jakedrew/SmartWatch/Version/D1/Board/PCB Cropped Final-1.jpg

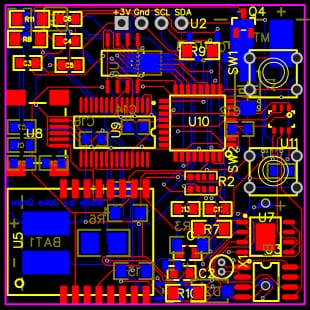
Version/D1/Board/PCB Cropped Final-1.jpg
