jakedrew/SmartWatch/Version/D2/Board/SmartWatch D2 PCB/PCB_SmartWatch D2 PCB_2020-10-05_16-55-16.png

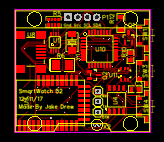
Version/D2/Board/SmartWatch D2 PCB/PCB_SmartWatch D2 PCB_2020-10-05_16-55-16.png
