jakedrew/SmartWatch/Version/D1/Board/V1/PCB_V1_2020-10-05_14-33-06.pdf

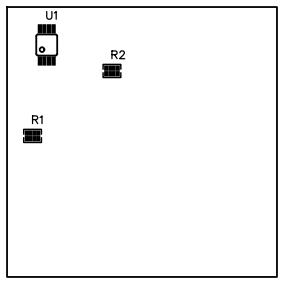
[picture p40: figure]
