jakedrew/SmartWatch/Version/D1/Board/V1/PCB_V1_2020-10-05_14-34-22.pdf

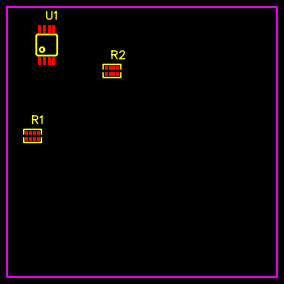
[picture p41: figure]
