jakedrew/SmartWatch/Datasheets/ATMega328/Screen Shot 2017-11-06 at 10.45.25.png

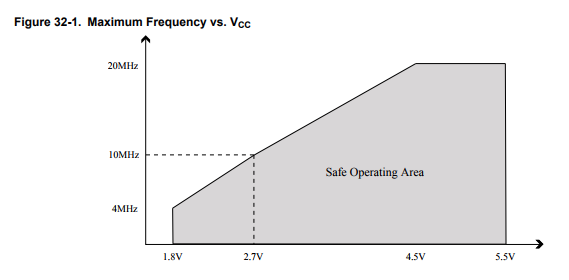
Datasheets/ATMega328/Screen Shot 2017-11-06 at 10.45.25.png
