jakedrew/SmartWatch/Datasheets/ATMega328/Screen Shot 2017-11-15 at 13.26.10.png

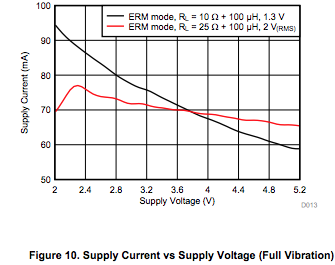
Datasheets/ATMega328/Screen Shot 2017-11-15 at 13.26.10.png
