jakedrew/SmartWatch/Datasheets/ATMega328/Screen Shot 2017-11-15 at 13.30.06.png

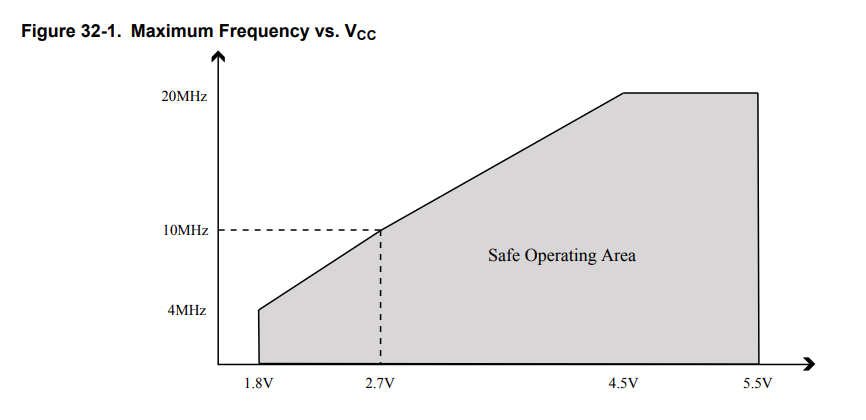
Datasheets/ATMega328/Screen Shot 2017-11-15 at 13.30.06.png
