jakedrew/SmartWatch/Datasheets/ATMega328/Screen Shot 2017-11-21 at 15.36.22.png

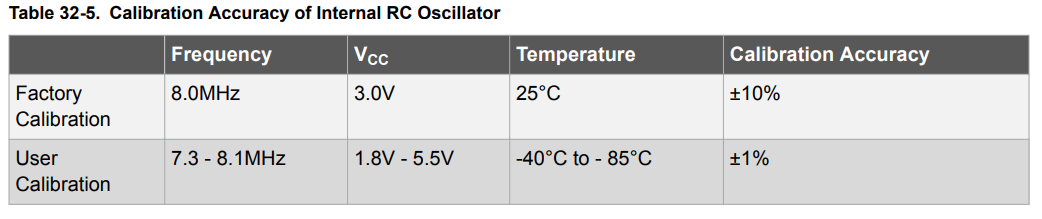
Datasheets/ATMega328/Screen Shot 2017-11-21 at 15.36.22.png
