jakedrew/SmartWatch/Datasheets/ATMega328/Screen Shot 2017-11-21 at 15.51.56.png

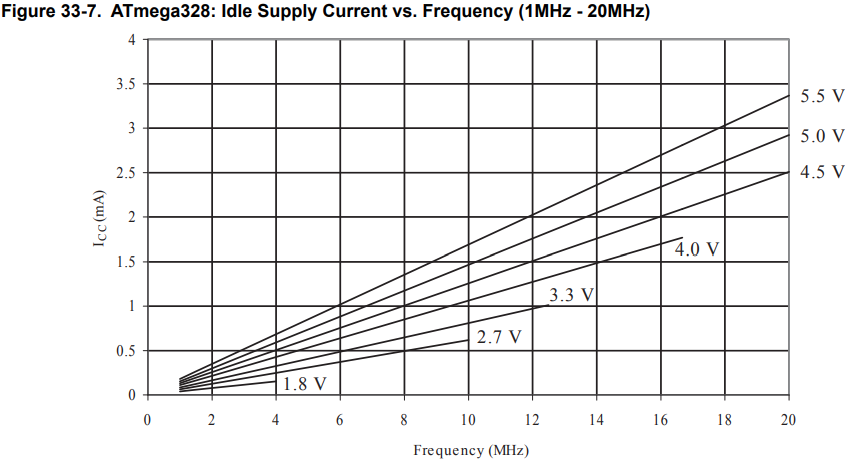
Datasheets/ATMega328/Screen Shot 2017-11-21 at 15.51.56.png
