jakedrew/SmartWatch/Datasheets/DRV2605L/Screen Shot 2017-11-17 at 13.19.39.png

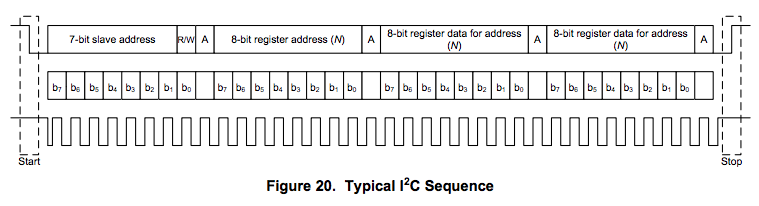
Datasheets/DRV2605L/Screen Shot 2017-11-17 at 13.19.39.png
