jakedrew/SmartWatch/Datasheets/DRV2605L/Screen Shot 2017-11-17 at 13.20.35.png

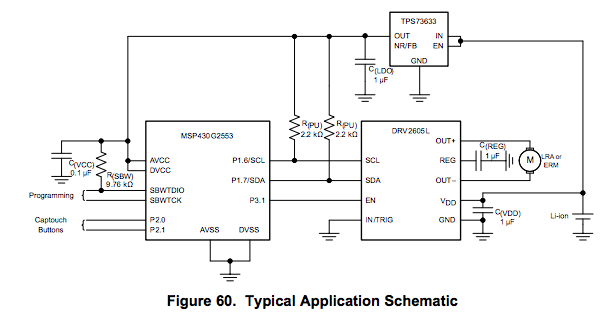
Datasheets/DRV2605L/Screen Shot 2017-11-17 at 13.20.35.png
