jakedrew/SmartWatch/Datasheets/DS1338Z-33/Screen Shot 2017-11-17 at 13.15.22.png

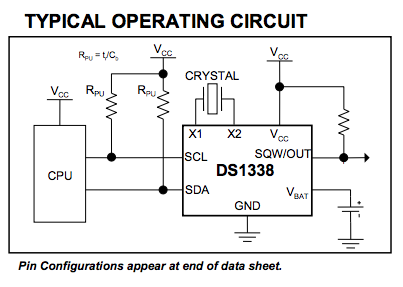
Datasheets/DS1338Z-33/Screen Shot 2017-11-17 at 13.15.22.png
