jakedrew/SmartWatch/Datasheets/MCP9808-EMS/Screen Shot 2017-11-17 at 13.23.54.png

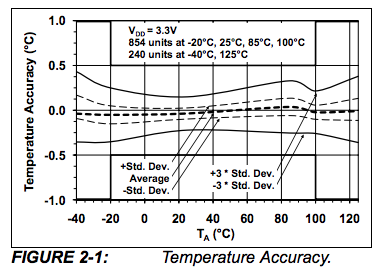
Datasheets/MCP9808-EMS/Screen Shot 2017-11-17 at 13.23.54.png
