jakedrew/SmartWatch/Datasheets/MCP9808-EMS/Screen Shot 2017-11-17 at 13.25.48.png

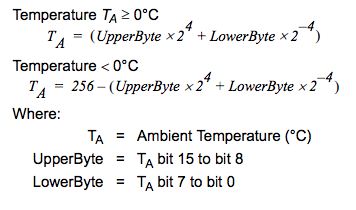
Datasheets/MCP9808-EMS/Screen Shot 2017-11-17 at 13.25.48.png
