jakedrew/SmartWatch/Datasheets/REG710NA-3.33K/Screen Shot 2017-11-17 at 13.33.44.png

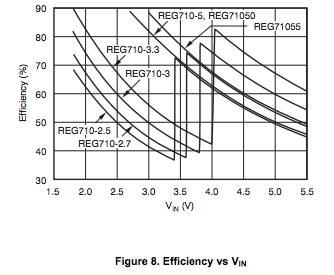
Datasheets/REG710NA-3.33K/Screen Shot 2017-11-17 at 13.33.44.png
