jakedrew/SmartWatch/output_14_0.png

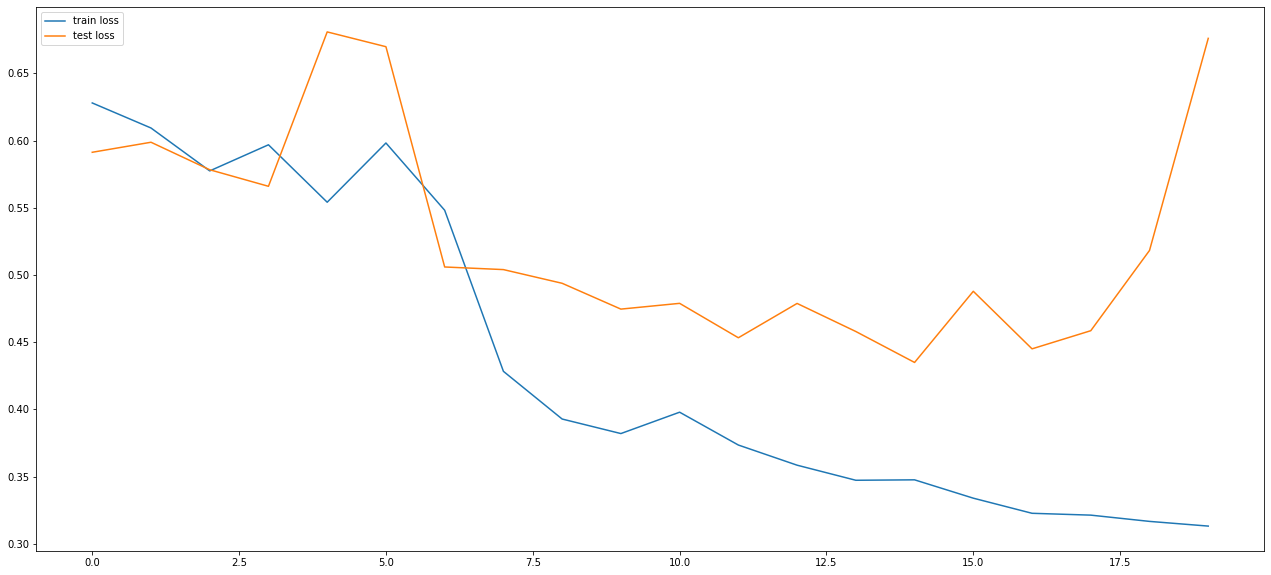
output_14_0.png
