jakedrew/SmartWatch/output_15_0.png

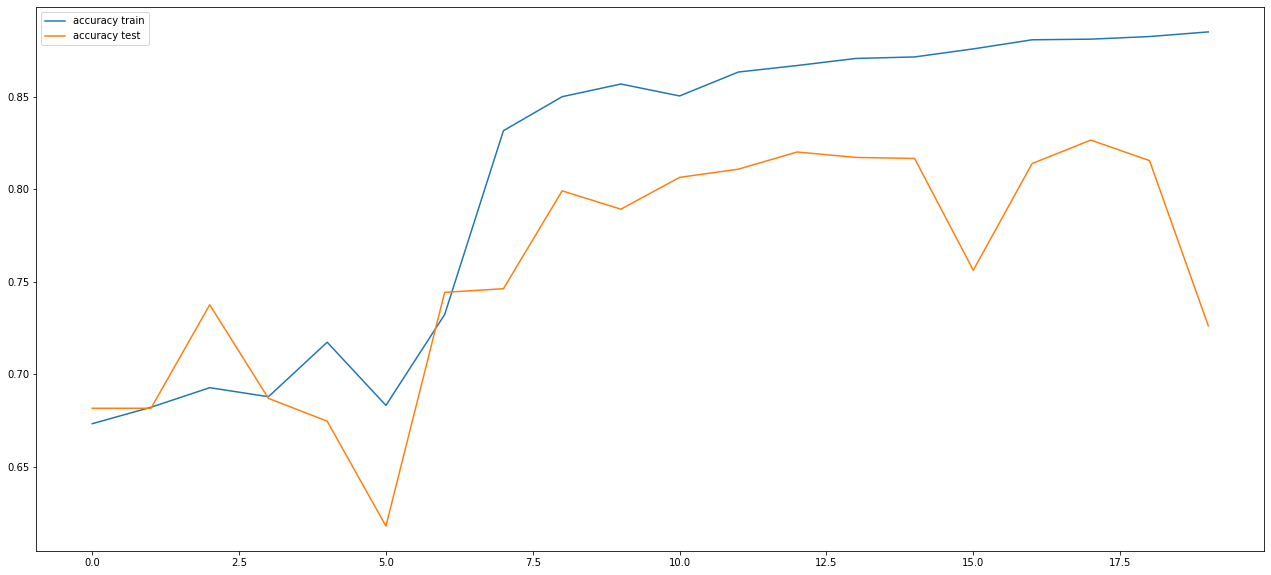
output_15_0.png
