jakedrew/SmartWatch/output_23_0.png

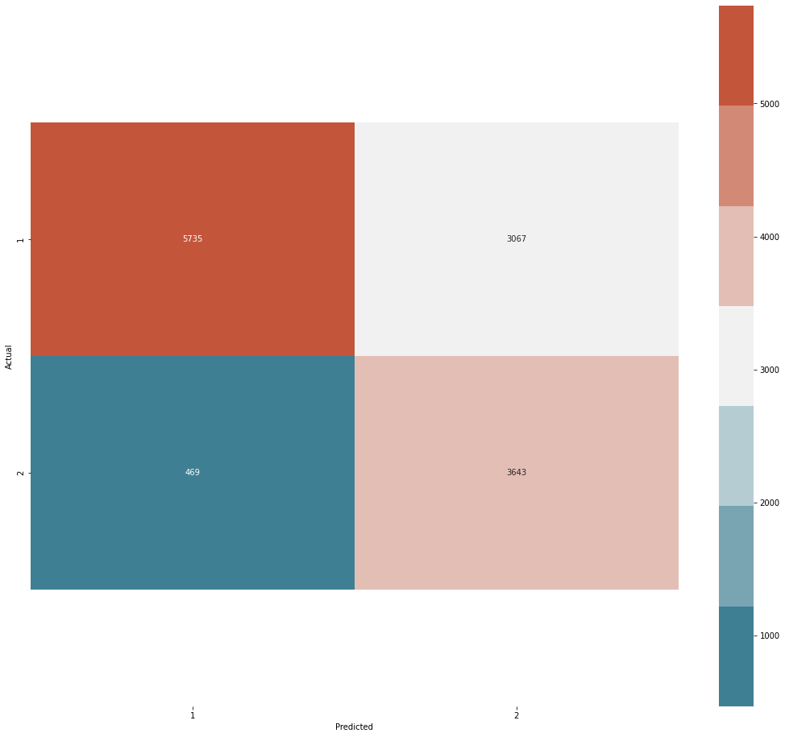
output_23_0.png
