jakedrew/SmartWatch/output_24_0.png

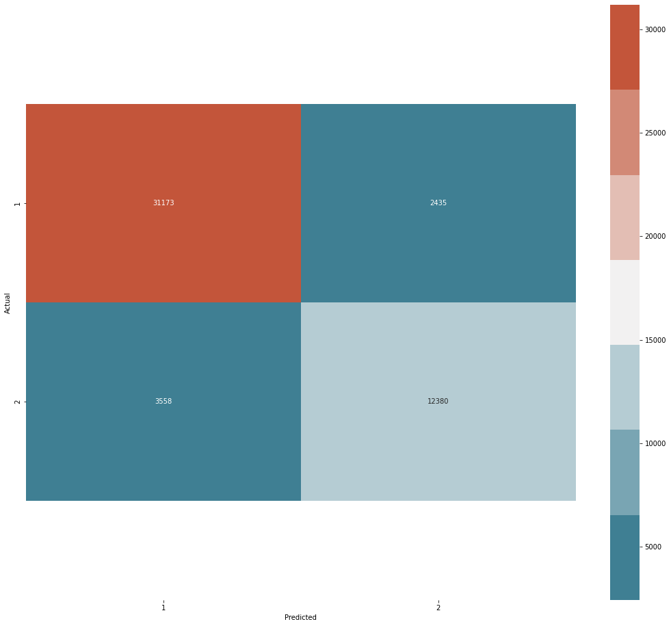
output_24_0.png
