jakedrew/SmartWatch/output_25_0.png

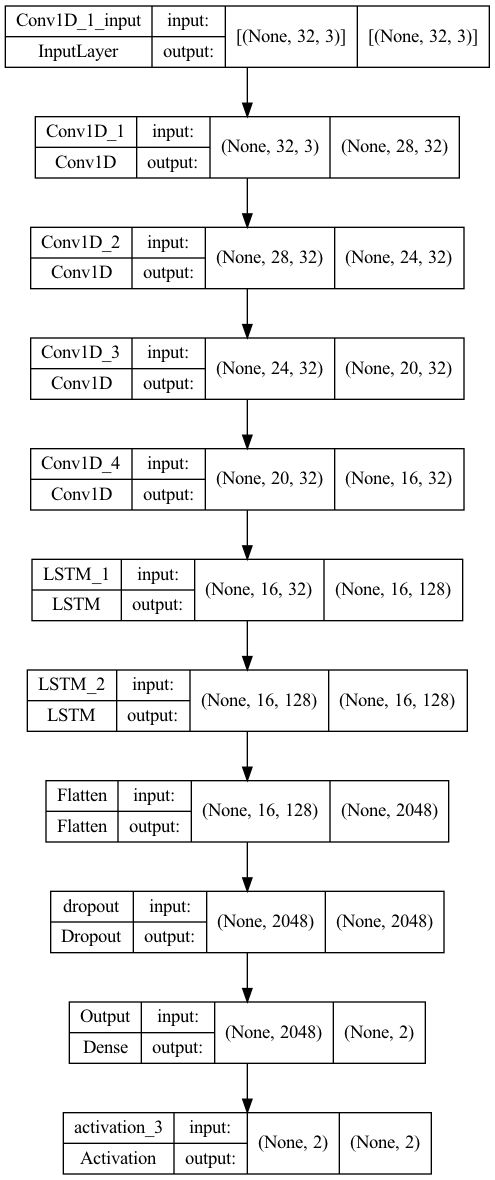
output_25_0.png
