jakedrew/SmartWatch/Version/D1/Board/Fin/PCB_Fin_2020-10-05_16-10-18.png

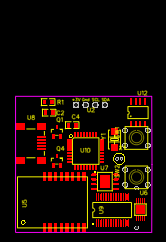
Version/D1/Board/Fin/PCB_Fin_2020-10-05_16-10-18.png
