jakedrew/SmartWatch/Version/D1/Board/New PCB/PCB_New PCB_2020-10-05_14-35-52.png

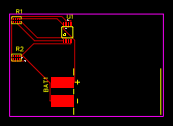
Version/D1/Board/New PCB/PCB_New PCB_2020-10-05_14-35-52.png
