jakedrew/SmartWatch/Version/D1/Board/PCB1/PCB_PCB1_2020-10-05_14-45-28.png

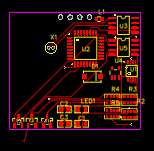
Version/D1/Board/PCB1/PCB_PCB1_2020-10-05_14-45-28.png
