jakedrew/SmartWatch/Version/D1/Circuit/V1.1/Schematic_D1_2020-10-05_14-30-19.png

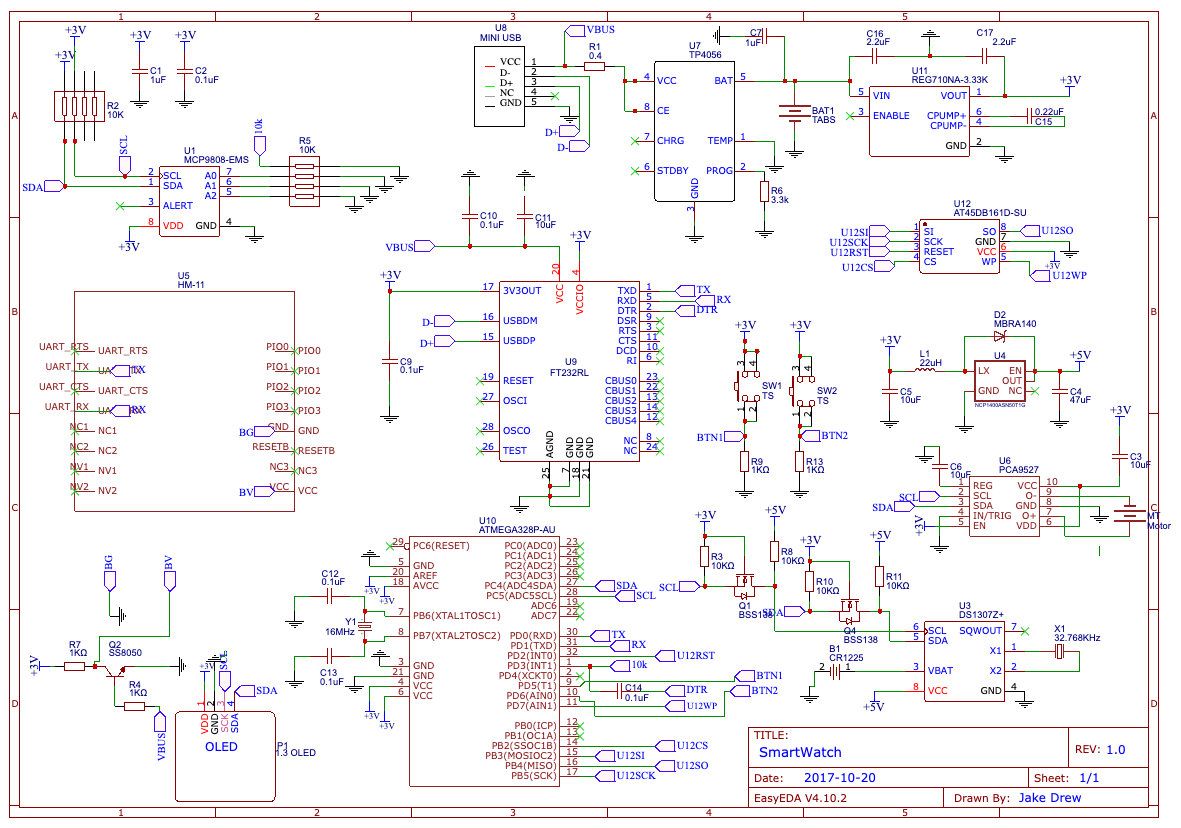
Version/D1/Circuit/V1.1/Schematic_D1_2020-10-05_14-30-19.png
