jakedrew/SmartWatch/Version/D2/Board/New PCB/PCB_New PCB_2020-10-05_16-17-32.png

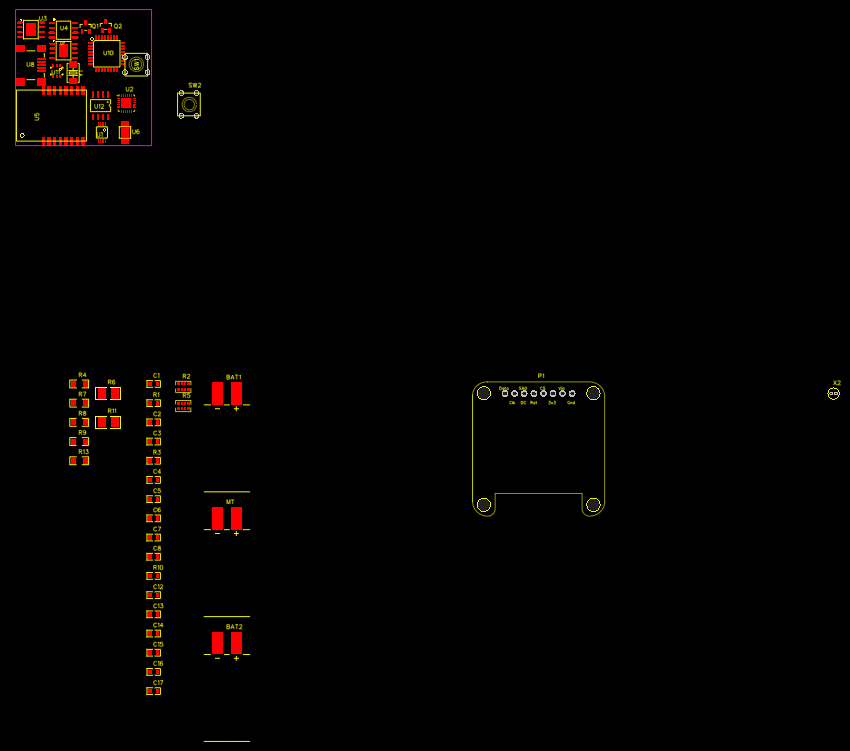
Version/D2/Board/New PCB/PCB_New PCB_2020-10-05_16-17-32.png
