jakedrew/SmartWatch/Version/D3/Circuit/V4.1/V4.1.png

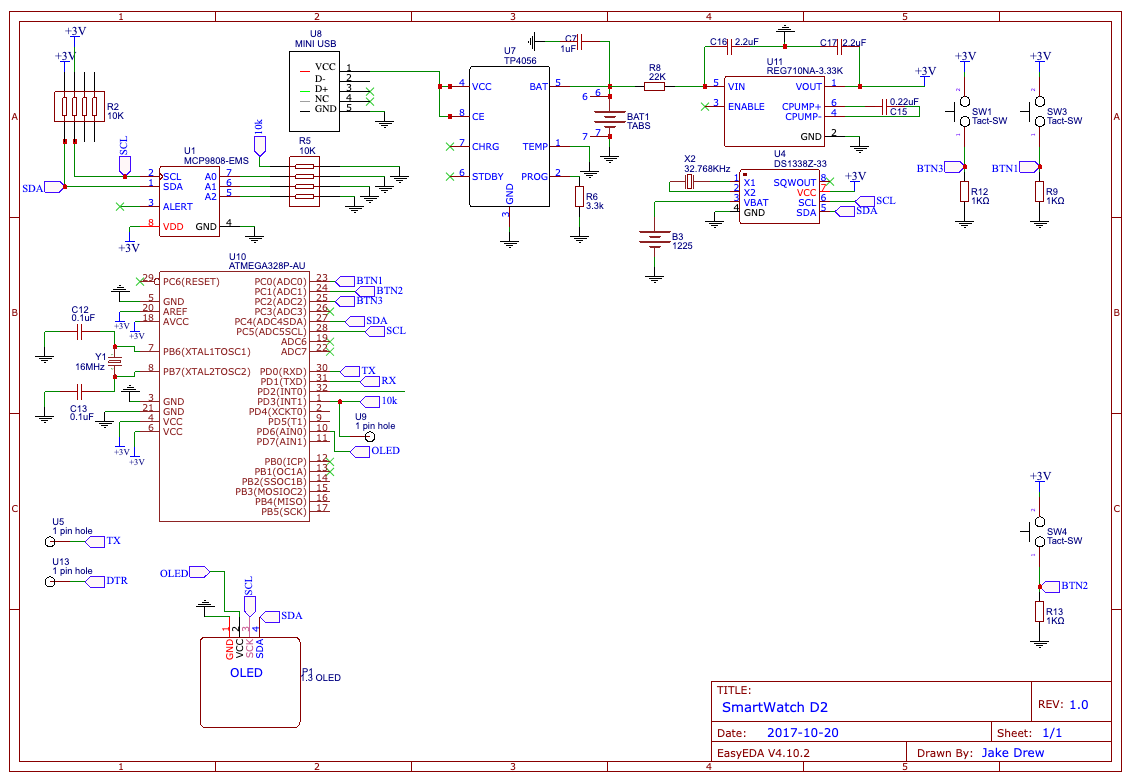
Version/D3/Circuit/V4.1/V4.1.png
