jakedrew/SmartWatch/Version/D4/Board/PCB_D4_2020-10-05_17-05-44.png

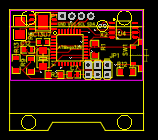
Version/D4/Board/PCB_D4_2020-10-05_17-05-44.png
