jakedrew/SmartWatch/Version/D4/Circuit/V4.1/Schematic_D4_2020-10-05_17-04-26.png

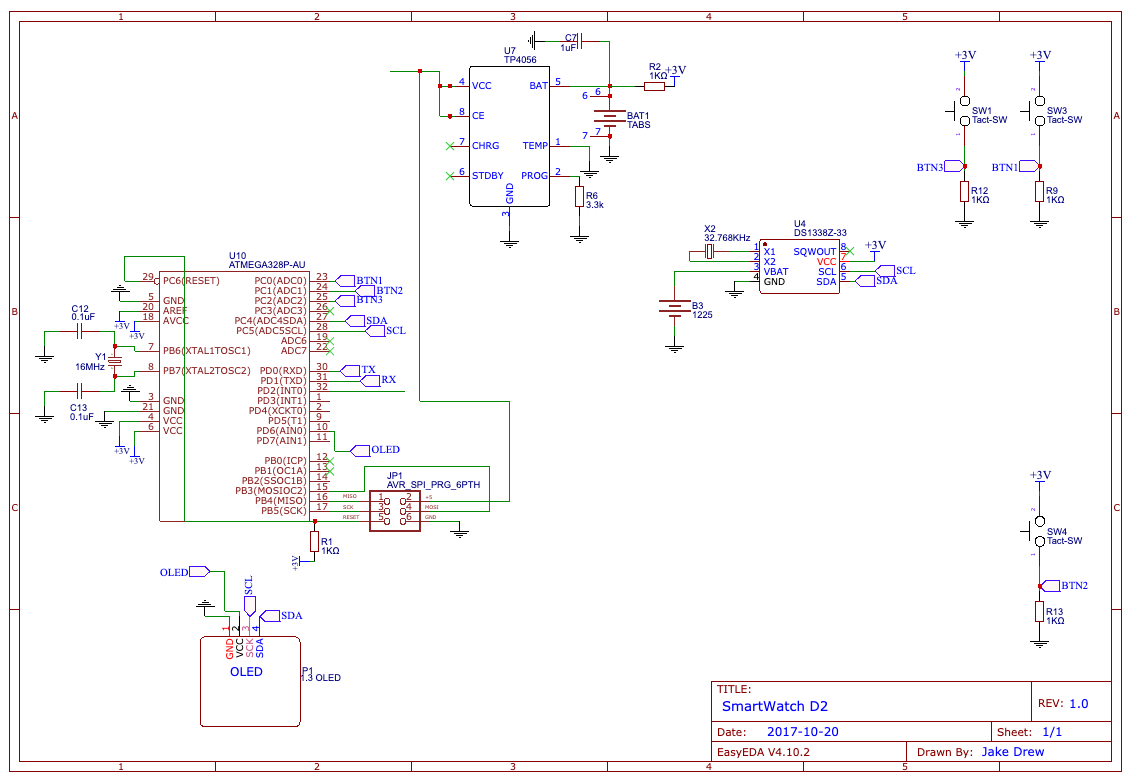
Version/D4/Circuit/V4.1/Schematic_D4_2020-10-05_17-04-26.png
