jakedrew/SmartWatch/Version/D5/Board/Images/BoardOutLine.png

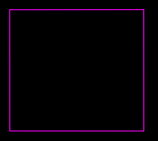
Version/D5/Board/Images/BoardOutLine.png
