jakedrew/SmartWatch/Version/D5/Board/Images/BottomLayer.png

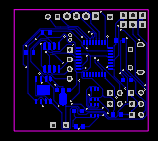
Version/D5/Board/Images/BottomLayer.png
