jakedrew/SmartWatch/Version/D5/Board/Images/BottomPasteMaskLayer.png

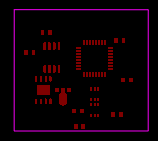
Version/D5/Board/Images/BottomPasteMaskLayer.png
