jakedrew/SmartWatch/Version/D5/Board/Images/BottomSilkLayer.png

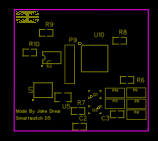
Version/D5/Board/Images/BottomSilkLayer.png
