jakedrew/SmartWatch/Version/D5/Board/Images/Multi-Layer.png

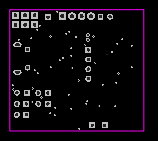
Version/D5/Board/Images/Multi-Layer.png
