jakedrew/SmartWatch/Version/D5/Board/Images/TopLayer.png

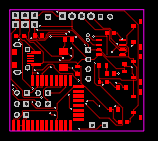
Version/D5/Board/Images/TopLayer.png
