jakedrew/SmartWatch/Version/D5/Board/Images/TopPasteMaskLayer.png

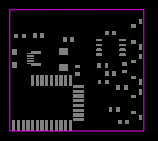
Version/D5/Board/Images/TopPasteMaskLayer.png
