jakedrew/SmartWatch/Version/D5/Board/Images/TopSilkLayer.png

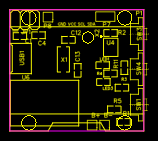
Version/D5/Board/Images/TopSilkLayer.png
