jakedrew/SmartWatch/Version/D5/Circuit/ADT75/ADT75.png

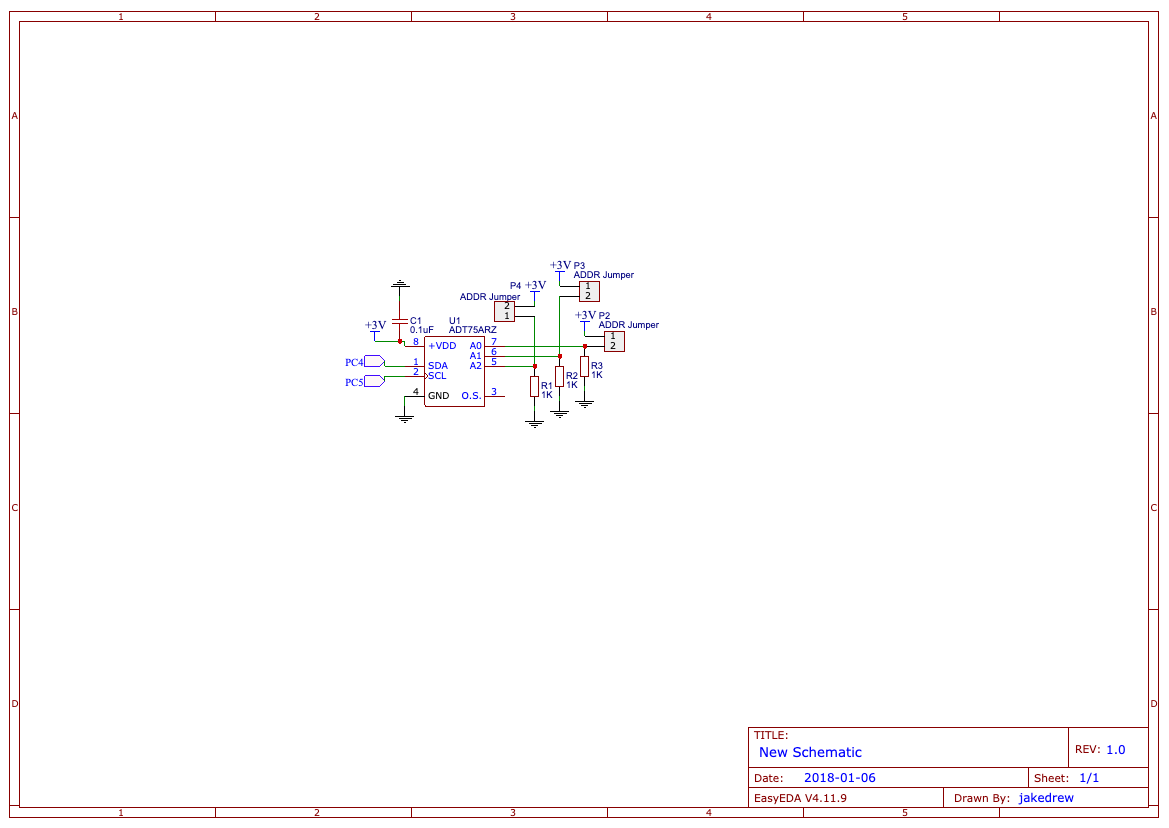
Version/D5/Circuit/ADT75/ADT75.png
