jakedrew/SmartWatch/Version/D5/Circuit/BMP180/BMP180.png

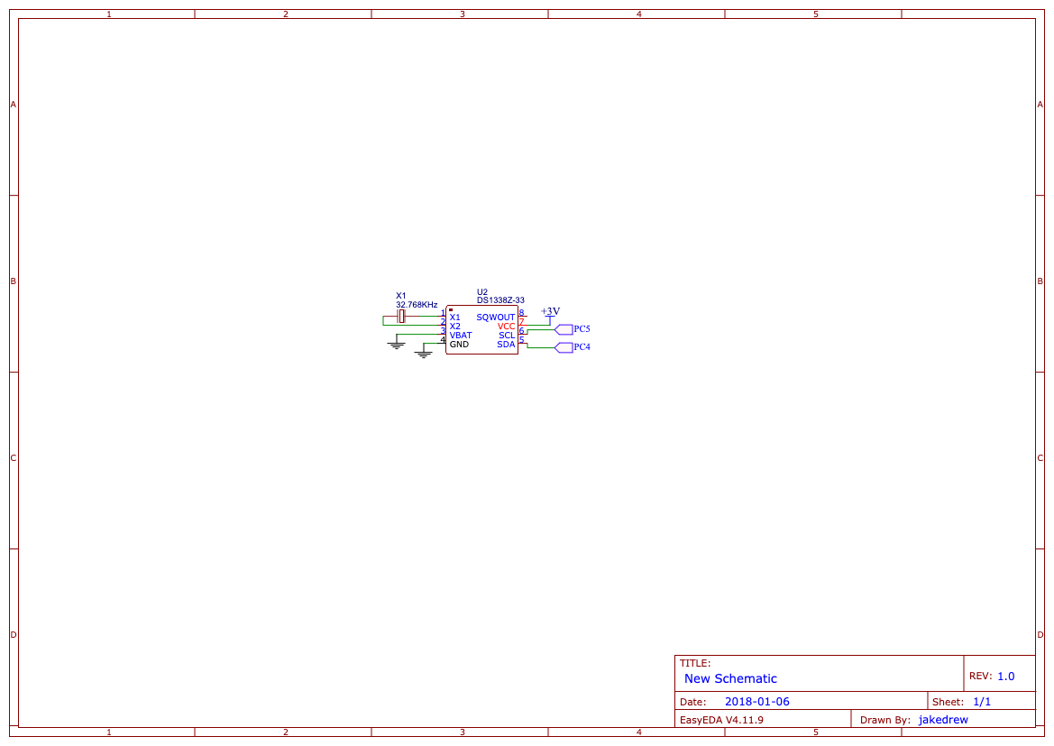
Version/D5/Circuit/BMP180/BMP180.png
