jakedrew/SmartWatch/Version/D5/Circuit/DS1338/DS1338.png

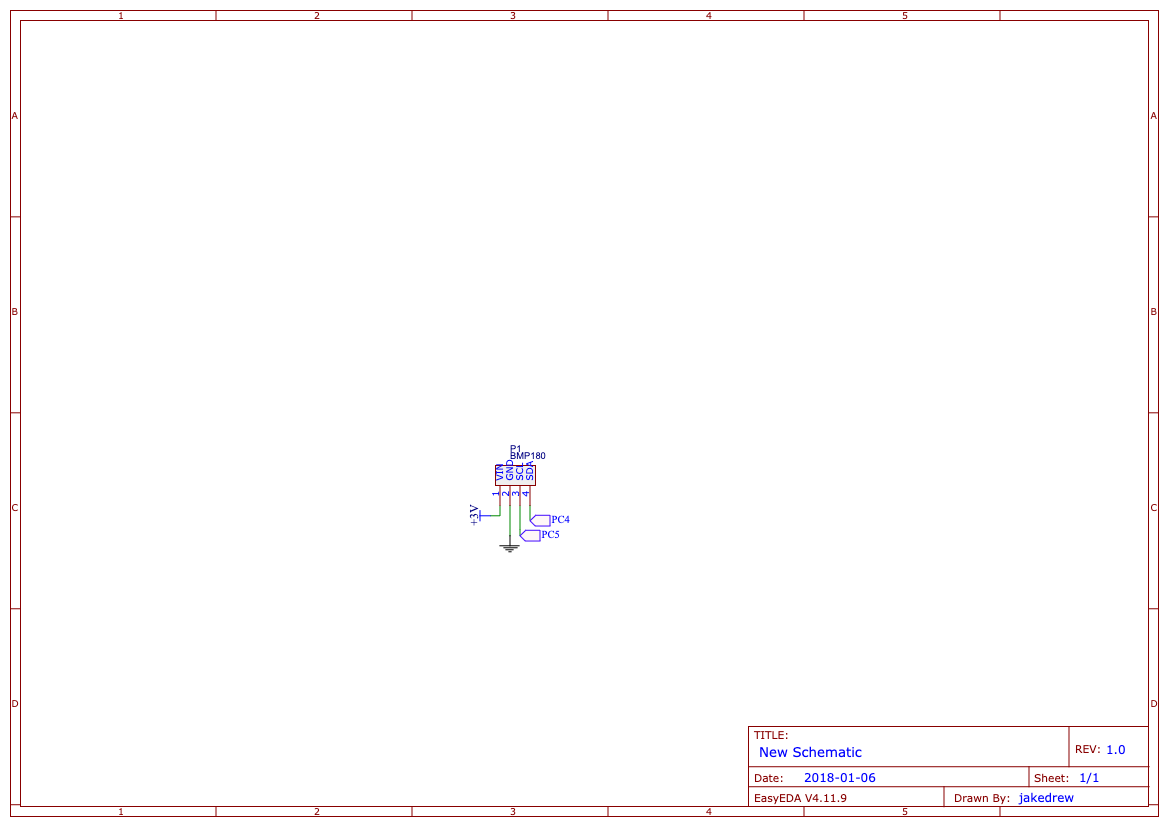
Version/D5/Circuit/DS1338/DS1338.png
