jakedrew/SmartWatch/Version/D5/Circuit/OLED/OLED.png

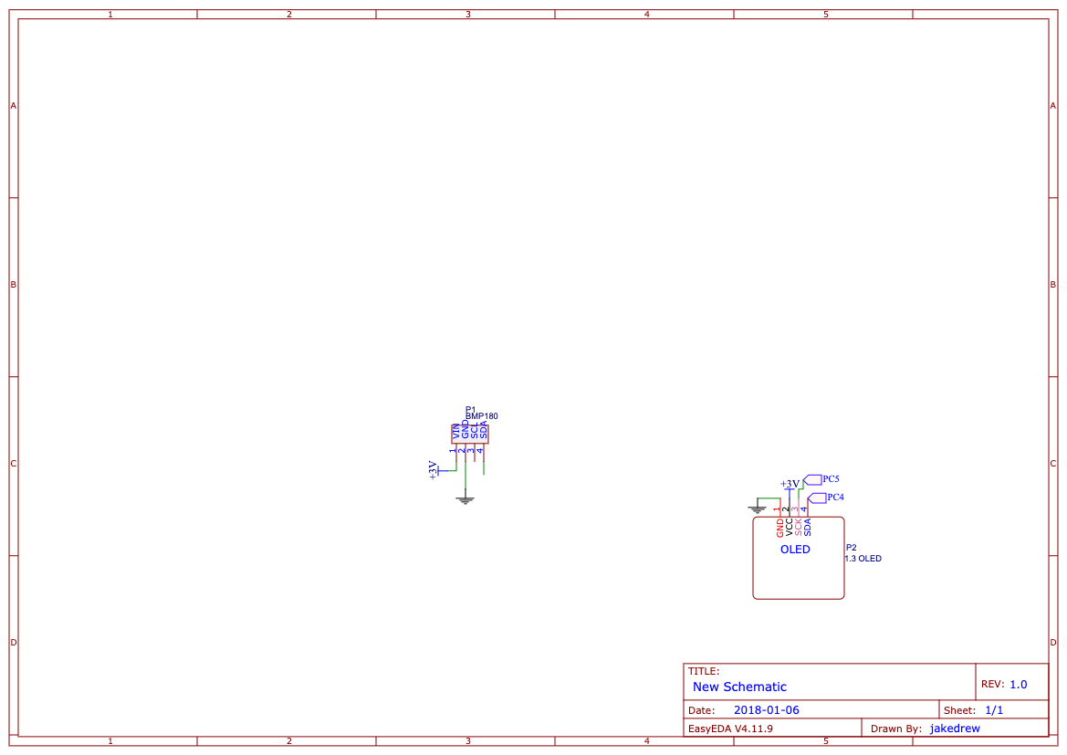
Version/D5/Circuit/OLED/OLED.png
