jakedrew/SmartWatch/Version/D5/Circuit/Power management/Power management.png

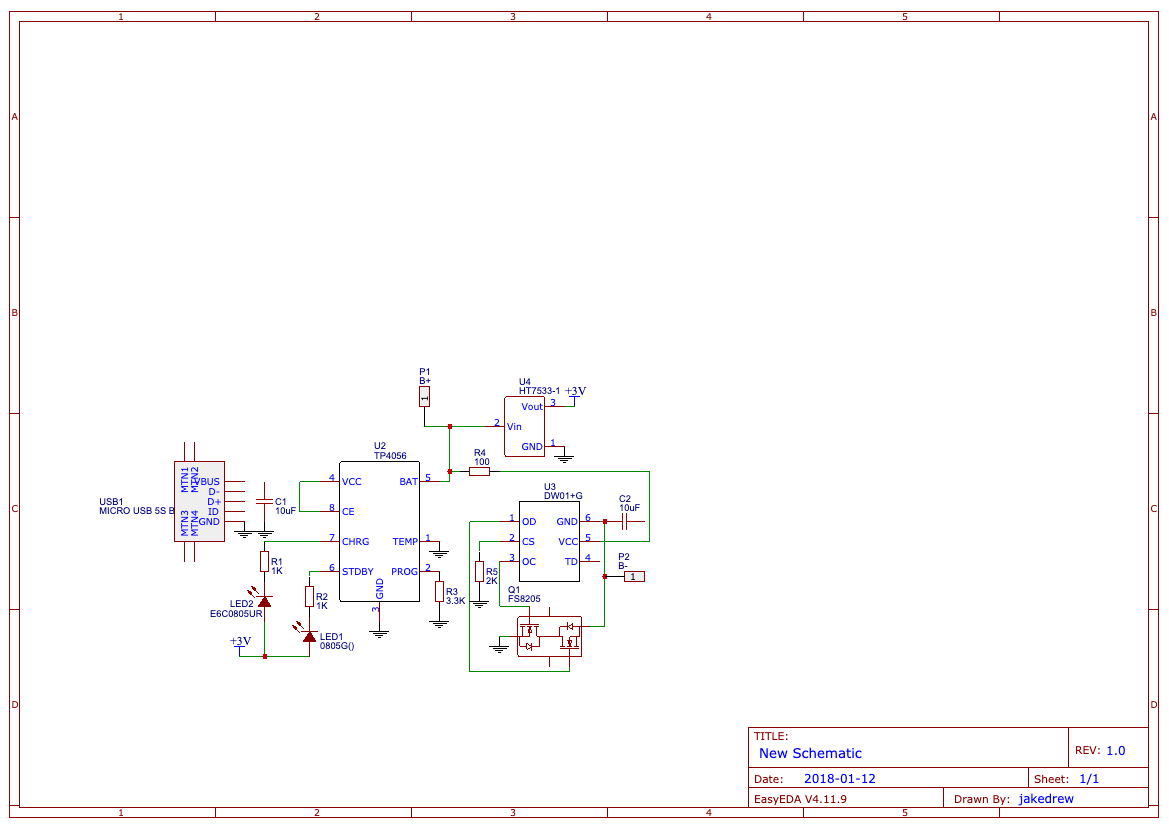
Version/D5/Circuit/Power management/Power management.png
