jakedrew/SmartWatch/Version/D5/Circuit/V5/V5.png

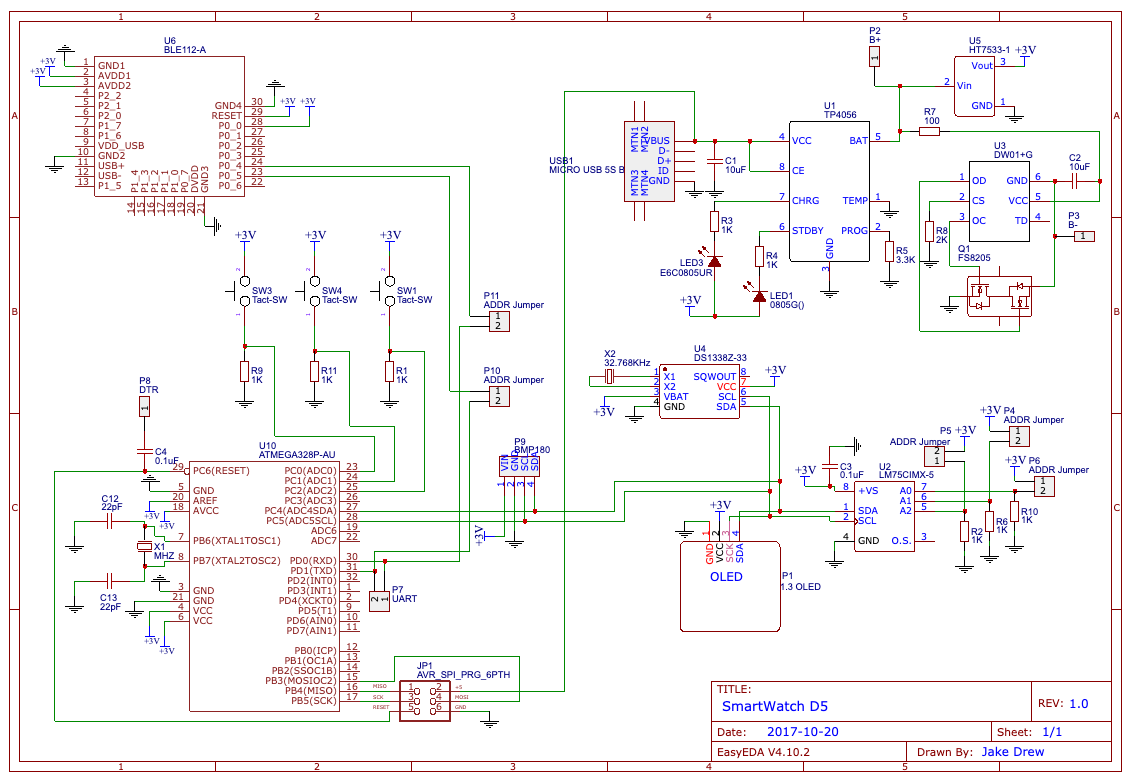
Version/D5/Circuit/V5/V5.png
