jakedrew/SmartWatch/Version/D5/Screen Shot 2018-01-06 at 11.16.53.png

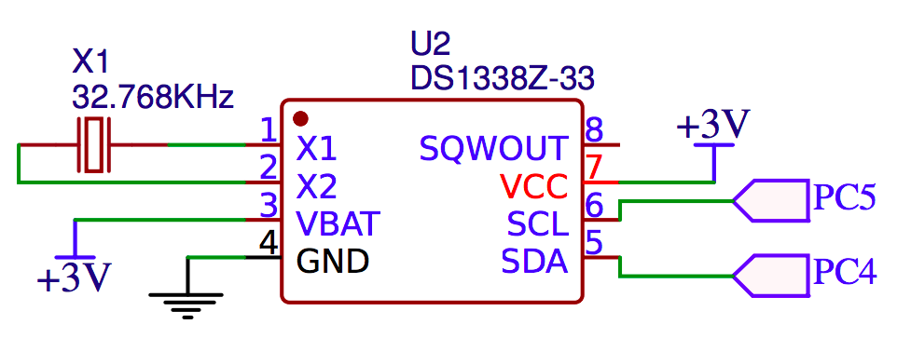
Version/D5/Screen Shot 2018-01-06 at 11.16.53.png
