jakedrew/SmartWatch/Version/D5/Screen Shot 2018-01-06 at 18.16.48.png

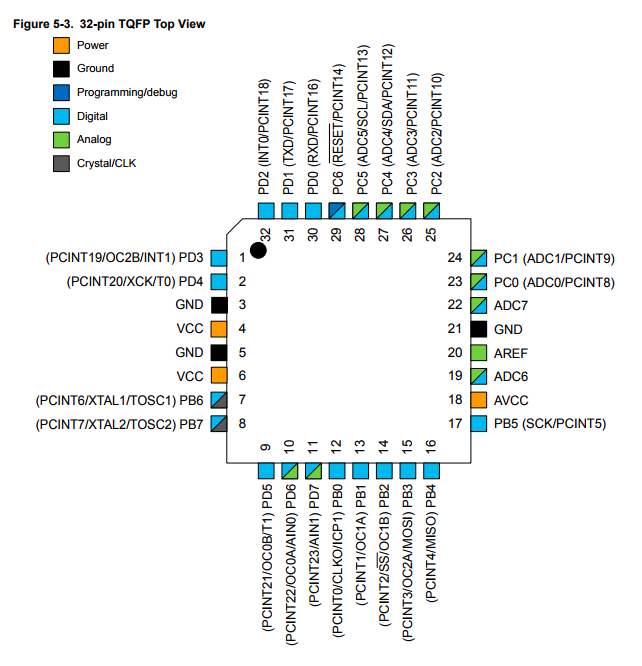
Version/D5/Screen Shot 2018-01-06 at 18.16.48.png
