jakedrew/SmartWatch/Version/D5/Screen Shot 2018-01-08 at 11.17.41.png

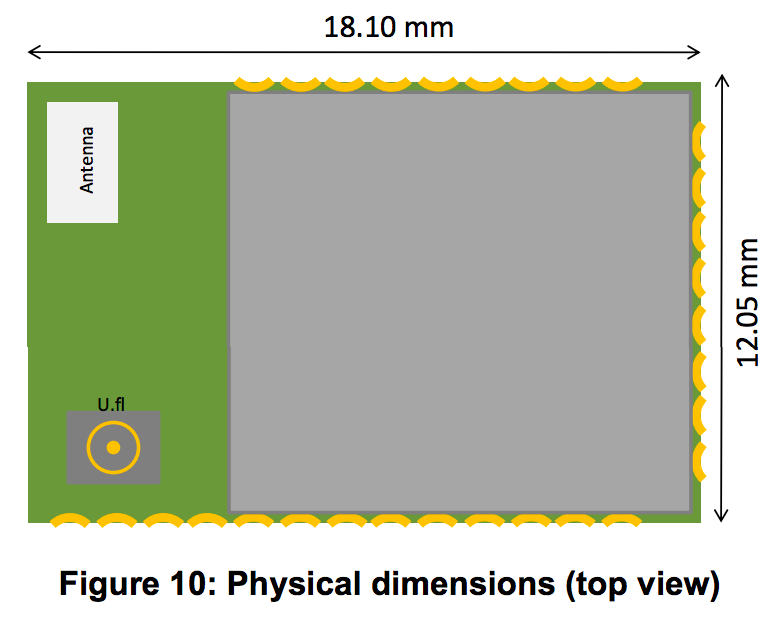
Version/D5/Screen Shot 2018-01-08 at 11.17.41.png
