jakedrew/SmartWatch/Version/D5/Screen Shot 2018-01-08 at 14.38.57.png

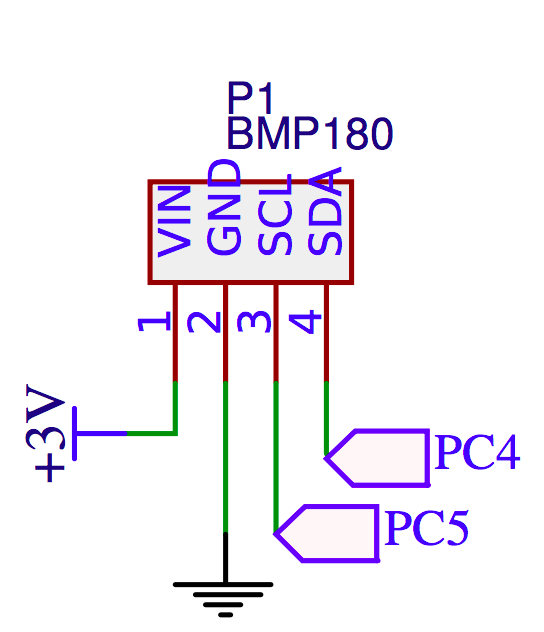
Version/D5/Screen Shot 2018-01-08 at 14.38.57.png
