jakedrew/SmartWatch/Version/D5/Screen Shot 2018-01-08 at 15.36.48.png

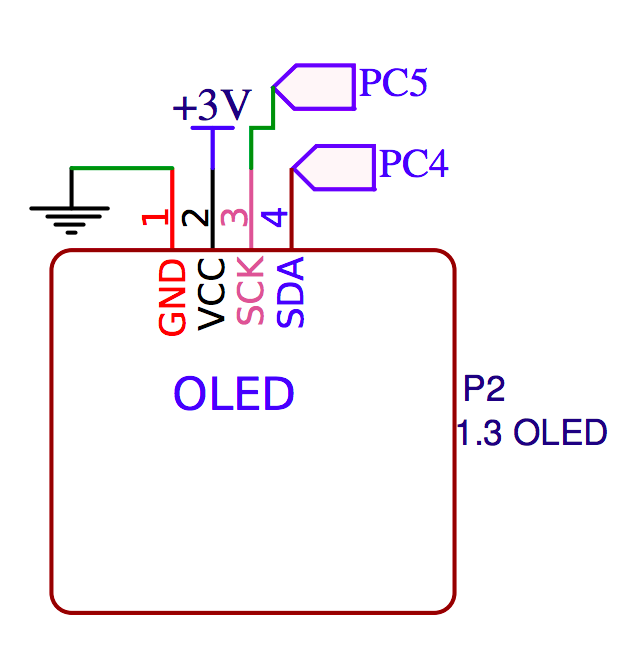
Version/D5/Screen Shot 2018-01-08 at 15.36.48.png
