jakedrew/SmartWatch/Version/D5/Screen Shot 2018-01-08 at 16.34.32.png

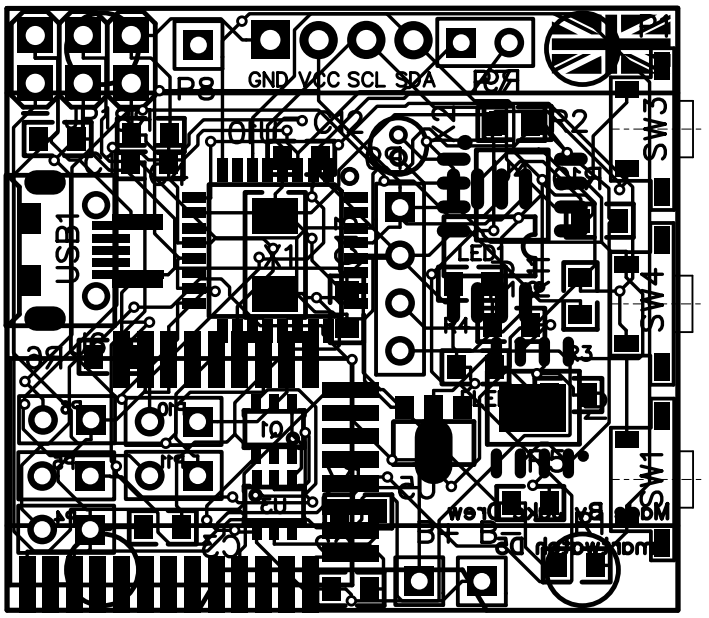
Version/D5/Screen Shot 2018-01-08 at 16.34.32.png
