jakedrew/SmartWatch/Version/D1/BOM_D1_2020-10-05_16-57-24.csv

ID | Name | Designator | Footprint | Quantity | Manufacturer Part | Manufacturer | Supplier | Supplier Part | LCSC Assembly
1 | MCP9808-EMS | U1 | MSOP8 | 1 | ?
2 | 1uF | C1,C7 | 0805 | 2 | 0805B105K250NT | FH(风华) | LCSC | C89190
3 | DS1307Z+ | U3 | SOIC-8_150MIL | 1 | DS1307Z+T&R | MAXIM | LCSC | C9868
4 | 0.1uF | C2,C9,C10,C12,C13,C14 | 0805 | 6 | 0805B105K250NT | FH(风华) | LCSC | C89190
5 | 32.768KHz | X1 | 3*8 | 1 | DT-38 32.768KHz | KDS | LCSC | C93228
6 | NCP1400ASN50T1G | U4 | SOT23-5 | 1 | ?
7 | 22uH | L1 | SMD-2P-2.0X1.2X1.0MM | 1 | SDFL2012T220KTF
8 | 10K | R5,R2 | 0603_X4 | 2 | 4D03WGJ0102T5E | UniOhm | LCSC | C20197 | Yes
9 | MBRA140 | D2 | SMA-DIODE | 1 | ?
10 | 47uF | C4 | 0805 | 1 | 0805B105K250NT | FH(风华) | LCSC | C89190
11 | 10uF | C5,C11,C3,C6 | 0805 | 4 | 0805B105K250NT | FH(风华) | LCSC | C89190
12 | TABS | BAT1 | LIPO-110-TABS | 1 | ?
13 | TP4056 | U7 | SOP-8_EP_150MIL | 1 | TP4056 | TOPPOWER | LCSC | C16581 | Yes
14 | 0.4 | R1 | 0805 | 1 | 0805W8F147KT5E | UniOhm | LCSC | C68930
15 | 3.3k | R6 | 1210 | 1 | 1210W3F680KT5E | UniOhm | LCSC | C38887
16 | MINI USB | U8 | USB-MINI-B | 1 | ?
17 | FT232RL | U9 | SSOP-28_208MIL | 1 | FT232RL-REEL | FTDI | LCSC | C8690 | Yes
18 | ATMEGA328P-AU | U10 | TQFP32-0.8-7X7MM | 1 | ATMEGA328P-AU
19 | 16MHz | Y1 | X2-SMD-5.0X3.2X1.3MM | 1 | X053201602002
20 | REG710NA-3.33K | U11 | SOT-23-6 | 1 | ?
21 | 0.22uF | C15 | 0805 | 1 | 0805B105K250NT | FH(风华) | LCSC | C89190
22 | 2.2uF | C16,C17 | 0805 | 2 | 0805B105K250NT | FH(风华) | LCSC | C89190
23 | AT45DB161D-SU | U12 | SOIC-8 | 1 | ?
24 | 1.3 OLED | P1 | 1.3 OLED | 1 | ? |  | Aliexpress
25 | HM-11 | U5 | HM-11 | 1 | ?
26 | SS8050 | Q2 | SOT-23(SOT-23-3) | 1 | SS8050 | CJ | LCSC | C2150 | Yes
27 | PCA9527 | U6 | TSSOP10 | 1 | ?
28 | Motor | MT | LIPO-110-TABS | 1 | ?
29 | 1KΩ | R4,R7,R13,R9 | 1206 | 4 | 1206W4F1001T5E | UniOhm | LCSC | C4410 | Yes
30 | CR1225 | B1 | CR1225 WITH TAB | 1 | CR1220-2 | QJ
31 | BSS138 | Q1,Q4 | SOT-23-3 | 2 | BSS138 | CJ | LCSC | C78284
32 | 10KΩ | R3,R8,R10,R11 | 1206 | 4 | 1206W4F1002T5E | UniOhm | LCSC | C17902 | Yes
33 | TS | SW1,SW2 | SWITCH-6X6X5_TH | 2 | SWITCH-6x6x5_TH | LCSC | LCSC | C69330
