jakedrew/SmartWatch/Version/D2/BOM_D2_2020-10-05_16-55-55.csv

ID | Name | Designator | Footprint | Quantity | Manufacturer Part | Manufacturer | Supplier | Supplier Part | LCSC Assembly
1 | MCP9808-EMS | U1 | MSOP8 | 1 | ?
2 | 10uF | C1,C3,C6 | 0805 | 3 | 0805B105K250NT | FH(风华) | LCSC | C89190
3 | 10K | R5,R2 | 0603_X4 | 2 | 4D03WGJ0102T5E | UniOhm | LCSC | C20197 | Yes
4 | TABS | BAT1 | LIPO-110-TABS | 1 | ?
5 | 1uF | C7 | 0805 | 1 | 0805B105K250NT | FH(风华) | LCSC | C89190
6 | TP4056 | U7 | SOP-8_EP_150MIL | 1 | TP4056 | TOPPOWER | LCSC | C16581 | Yes
7 | 0.4 | R1 | 0805 | 1 | 0805W8F147KT5E | UniOhm | LCSC | C68930
8 | 3.3k | R6 | 1210 | 1 | 1210W3F680KT5E | UniOhm | LCSC | C38887
9 | MINI USB | U8 | USB-MINI-B | 1 | ?
10 | ATMEGA328P-AU | U10 | TQFP32-0.8-7X7MM | 1 | ATMEGA328P-AU
11 | 16MHz | Y1 | X2-SMD-5.0X3.2X1.3MM | 1 | X053201602002
12 | 0.1uF | C12,C13,C14,C5 | 0805 | 4 | 0805B105K250NT | FH(风华) | LCSC | C89190
13 | REG710NA-3.33K | U11 | SOT-23-6 | 1 | ?
14 | 0.22uF | C15 | 0805 | 1 | 0805B105K250NT | FH(风华) | LCSC | C89190
15 | 2.2uF | C16,C17 | 0805 | 2 | 0805B105K250NT | FH(风华) | LCSC | C89190
16 | AT45DB161D-SU | U12 | SOIC-8 | 1 | ?
17 | 1.3 OLED | P1 | OLED 1.3 IIC/I2C | 1 | ? |  | Aliexpress
18 | Haptic Motor | U6 | TSSOP10 | 1 | ?
19 | Motor | MT | LIPO-110-TABS | 1 | ?
20 | 1KΩ | R13,R9,R12 | 1206 | 3 | 1206W4F1001T5E | UniOhm | LCSC | C4410 | Yes
21 | MPU6050 | U2 | QFN-24_4X4X05P | 1 | MPU6050 | InvenSense | LCSC | C24112 | Yes
22 | DS1338Z-33 | U4 | SOP-8_150MIL | 1 | DS1338Z-33 | MAXIM | LCSC | C49105
23 | 32.768KHz | X2 | 3*8 | 1 | DT-38 32.768KHz | KDS | LCSC | C93228
24 | SS8050 | Q1,Q2,Q3 | SOT-23(SOT-23-3) | 3 | SS8050 | CJ | LCSC | C2150 | Yes
25 | 2.2KΩ | R10 | 0805 | 1 | 0805W8F2201T5E | UniOhm | LCSC | C17520 | Yes
26 | 2.2nF | C4 | 0805 | 1 | 0805B105K250NT | FH(风华) | LCSC | C89190
27 | 22K | R8 | 1206 | 1 | 1206W4F1001T5E | UniOhm | LCSC | C4410 | Yes
28 | Tact-SW | SW3,SW4,SW1 | TL3330AF260QG_3D | 3 | TL3330AF260QG |  | Mouser
29 | BLE112-A | U3 | BLE112-A | 1 | ?
30 | 1225 | B3 | LIPO-110-TABS | 1 | ?
31 | 1 pin hole | U5,U9,U13 | 1-PIN | 3 | 1 pin hole
