jakedrew/SmartWatch/Version/D5/BOM_D5_2020-10-05_16-57-39.csv

ID | Name | Designator | Footprint | Quantity | Manufacturer Part | Manufacturer | Supplier | Supplier Part | LCSC Assembly
1 | ATMEGA328P-AU | U10,U10 | TQFP32-0.8-7X7MM | 2 | ATMEGA328P-AU | ATMEL | LCSC | C14877
2 | 22pF | C12,C13,C12,C13 | 0805 | 4 | 0805B105K250NT | FH(风华) | LCSC | C89190
3 | 1.3 OLED | P1,P1,P2 | OLED 1.3 IIC/I2C | 3 | ? |  | Aliexpress
4 | DS1338Z-33 | U4,U2,U4 | SOP-8_150MIL | 3 | DS1338Z-33 | MAXIM | LCSC | C49105
5 | 32.768KHz | X2,X1,X2 | 3*8 | 3 | DT-38 32.768KHz | KDS | LCSC | C93228
6 | Tact-SW | SW3,SW4,SW1,SW3,SW4,SW1 | TL3330AF260QG_3D | 6 | TL3330AF260QG |  | Mouser
7 | AVR_SPI_PRG_6PTH | JP1,JP1 | 2X3 | 2 | ?
8 | MHZ | X1,X1 | OSC-YSX-5032_2P | 2 | X50328MSD2GC | YXC | LCSC | C18560 | Yes
9 | TP4056 | U1,U1,U2 | SOP-8_EP_150MIL | 3 | TP4056 | TOPPOWER | LCSC | C16581 | Yes
10 | 1K | R3,R4,R2,R6,R10,R1,R11,R9,R1,R2,R3,R3,R4,R2,R6,R10,R1,R11,R9,R1,R2 | 0805 | 21 | 0805W8F1602T5E | UniOhm | LCSC | C17490 | Yes
11 | 10uF | C1,C2,C1,C2,C1,C2 | 0805 | 6 | 0805B105K250NT | FH(风华) | LCSC | C89190
12 | LM75CIMX-5 | U2 | SOIC-8_150MIL | 1 | LM75CIMX-5 | TI | LCSC | C7965
13 | 0805G() | LED1,LED1,LED1 | 0805 | 3 | 0805G (Green) | ReliaPro | LCSC | C2297 | Yes
14 | E6C0805UR | LED3,LED3,LED2 | 0805 | 3 | E6C0805UR | ReliaPro | LCSC | C2295 | Yes
15 | MICRO USB 5S B | USB1,USB1,USB1 | MICRO-USB-1 | 3 | micro USBFemale | ValuePro | LCSC | C10418
16 | 3.3K | R5,R5,R3 | 0805 | 3 | 0805W8F1602T5E | UniOhm | LCSC | C17490 | Yes
17 | DW01+G | U3,U3,U3 | SOT-23-6 | 3 | DW01+G | FORTUNE | LCSC | C14213 | Yes
18 | 100 | R7,R7,R4 | 0805 | 3 | 0805W8F1602T5E | UniOhm | LCSC | C17490 | Yes
19 | FS8205 | Q1,Q1,Q1 | SOT-23-6 | 3 | FS8205 | FORTUNE | LCSC | C32254 | Yes
20 | 2K | R8,R8,R5 | 0805 | 3 | 0805W8F1602T5E | UniOhm | LCSC | C17490 | Yes
21 | B+ | P2,P2,P1 | HDR-1X1/2.54 | 3 | Header 1*1P | ReliaPro | LCSC | C81276
22 | B- | P3,P3,P2 | HDR-1X1/2.54 | 3 | Header 1*1P | ReliaPro | LCSC | C81276
23 | ADDR Jumper | P6,P4,P5,P10,P11,P2,P3,P4,P6,P4,P5,P10,P11 | HDR-1X2/2.54 | 13 | Header-Female-2.54_1x2 | LCSC | LCSC | C49661
24 | UART | P7,P7 | HDR-1X2/2.54 | 2 | Header-Female-2.54_1x2 | LCSC | LCSC | C49661
25 | 0.1uF | C3,C4,C1,C3,C4 | 0805 | 5 | 0805B105K250NT | FH(风华) | LCSC | C89190
26 | DTR | P8,P8 | HDR-1X1/2.54 | 2 | Header 1*1P | ReliaPro | LCSC | C81276
27 | HT7533-1 | U5,U5,U4 | SOT-89 | 3 | HT7533-1 | HOLTEK | LCSC | C14289 | Yes
28 | BMP180 | P9,P1,P1,P9,P1 | HDR-4X1/2.54 | 5 | Headers Pins 1*4P | ReliaPro | LCSC | C59481
29 | BLE112-A | U6,U6 | BLE112-A | 2 | ?
30 | ADT75ARZ | U1,U2 | SOIC-8_150MIL | 2 | LM75CIMX-5 | TI | LCSC | C7965
