jakedrew/SmartWatch/Version/D1/Board/Fin/Fin_2020-10-05_16-10-29.dxf

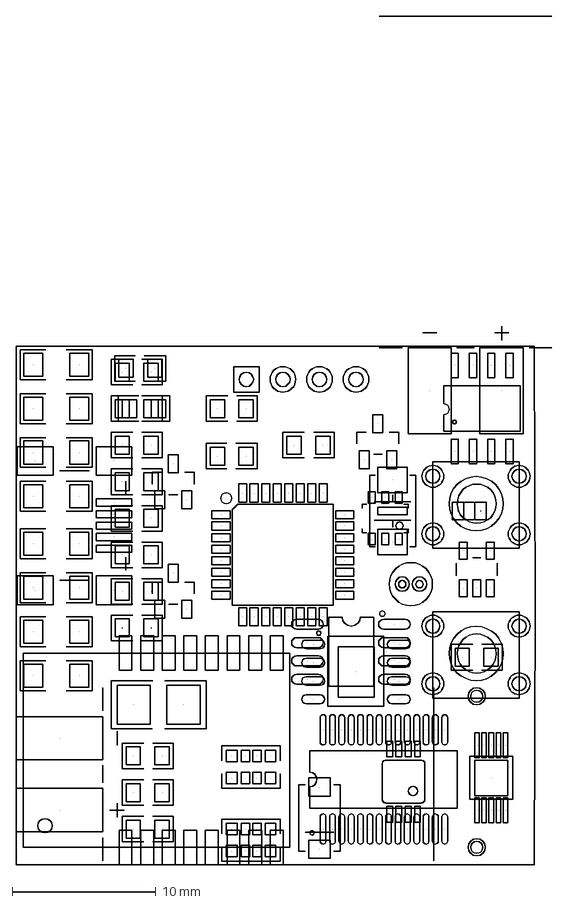
[picture p104: CAD file, 2020-10-05]
Version/D1/Board/Fin/Fin_2020-10-05_16-10-29.dxf
37.2 x 58.9 mm
