jakedrew/SmartWatch/Version/D1/Board/New PCB/New PCB_2020-10-05_14-36-07.dxf

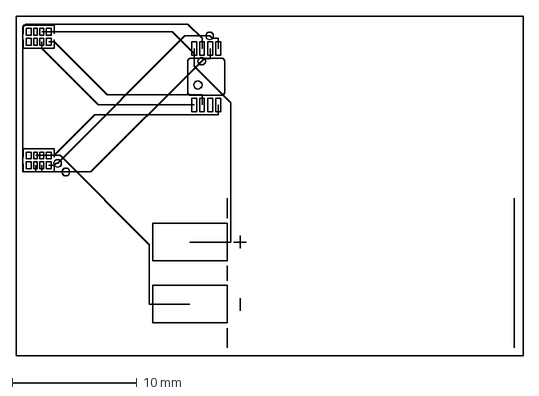
[picture p105: CAD file, 2020-10-05]
Version/D1/Board/New PCB/New PCB_2020-10-05_14-36-07.dxf
40.6 x 27.2 mm
