jakedrew/SmartWatch/Version/D1/Board/PCB Final/PCB Final_2020-10-05_16-12-09.dxf

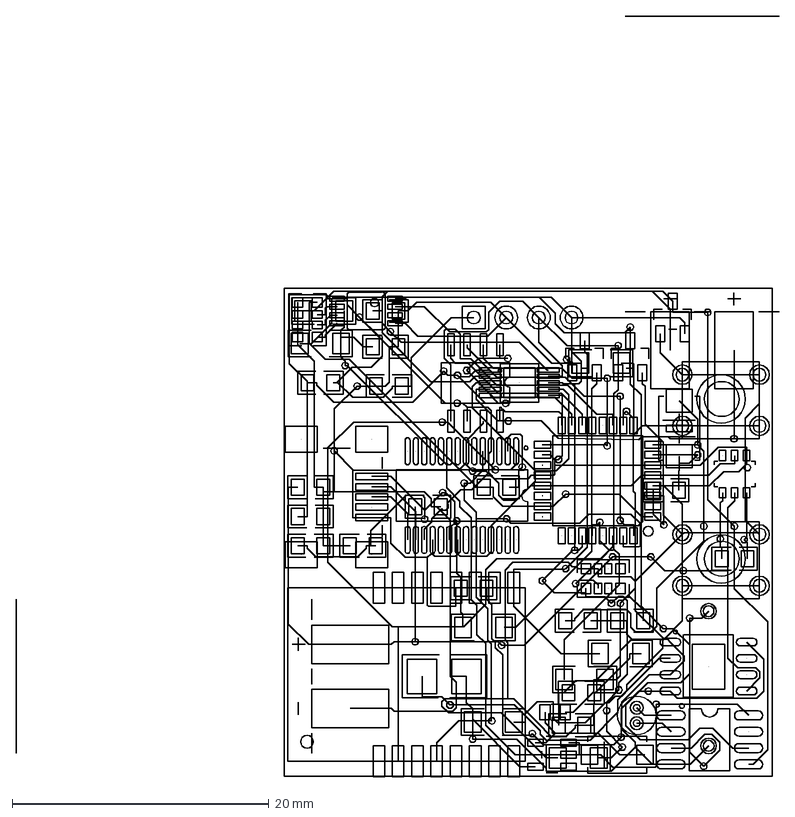
[picture p106: CAD file, 2020-10-05]
Version/D1/Board/PCB Final/PCB Final_2020-10-05_16-12-09.dxf
59.4 x 59.2 mm
