jakedrew/SmartWatch/Version/D1/Board/PCB1/PCB1_2020-10-05_14-45-50.dxf

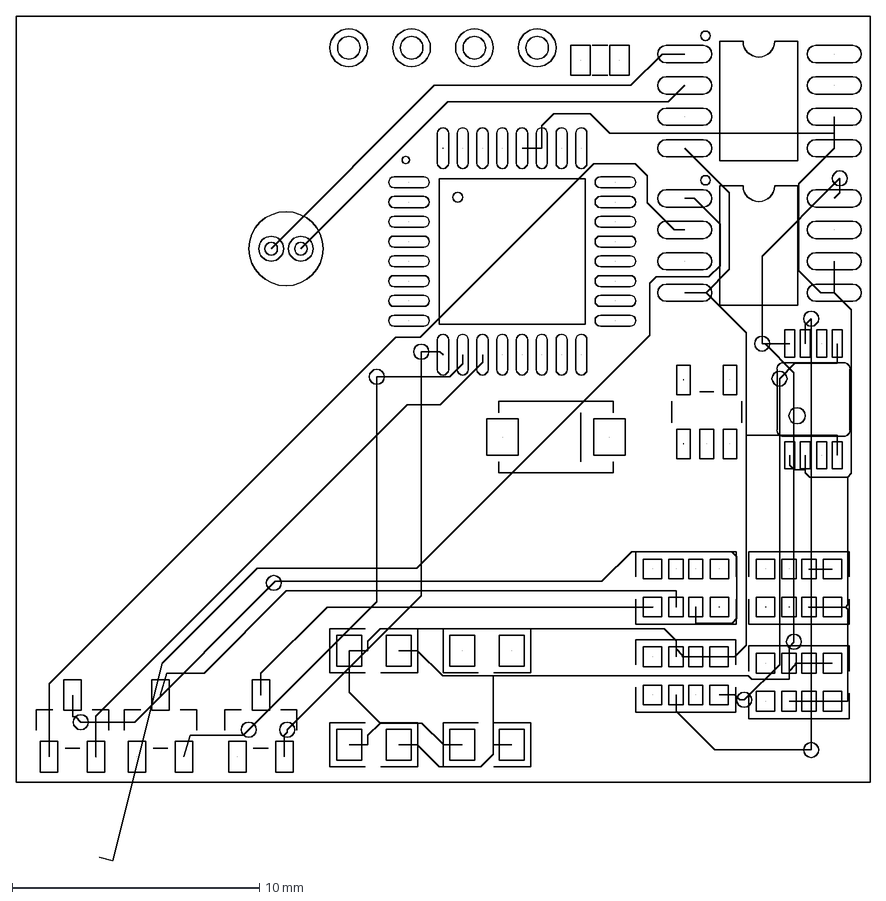
[picture p107: CAD file, 2020-10-05]
Version/D1/Board/PCB1/PCB1_2020-10-05_14-45-50.dxf
34.5 x 34.2 mm
