jakedrew/SmartWatch/Version/D1/Board/V1/V1_2020-10-05_14-34-33.dxf

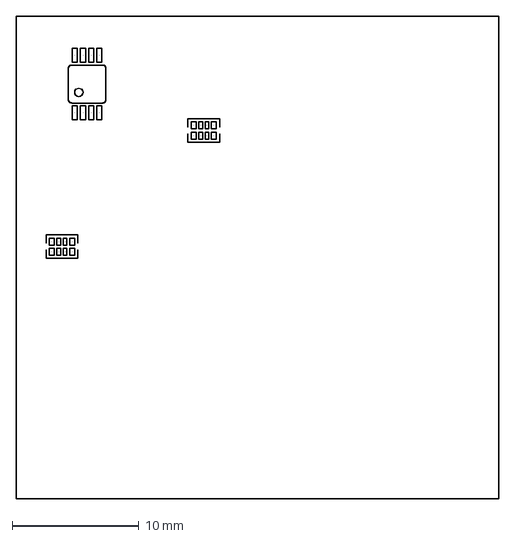
[picture p108: CAD file, 2020-10-05]
Version/D1/Board/V1/V1_2020-10-05_14-34-33.dxf
38.0 x 38.0 mm
