jakedrew/SmartWatch/Version/D2/Board/D2 PCB Final/D2 PCB Final_2020-10-05_16-49-59.dxf

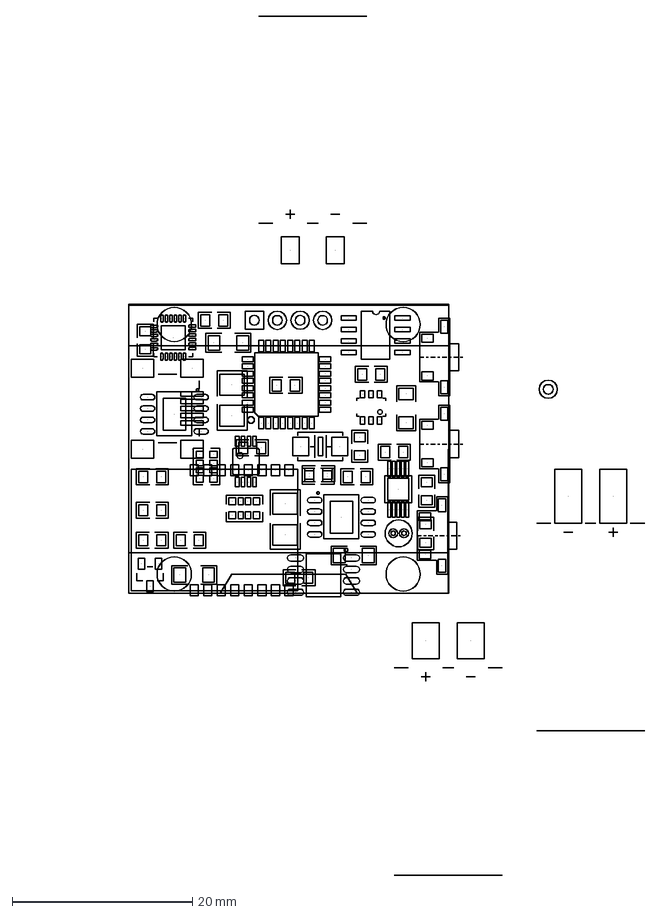
[picture p109: CAD file, 2020-10-05]
Version/D2/Board/D2 PCB Final/D2 PCB Final_2020-10-05_16-49-59.dxf
69.7 x 95.3 mm
