jakedrew/SmartWatch/Version/D2/Board/New PCB/New PCB_2020-10-05_16-17-58.dxf

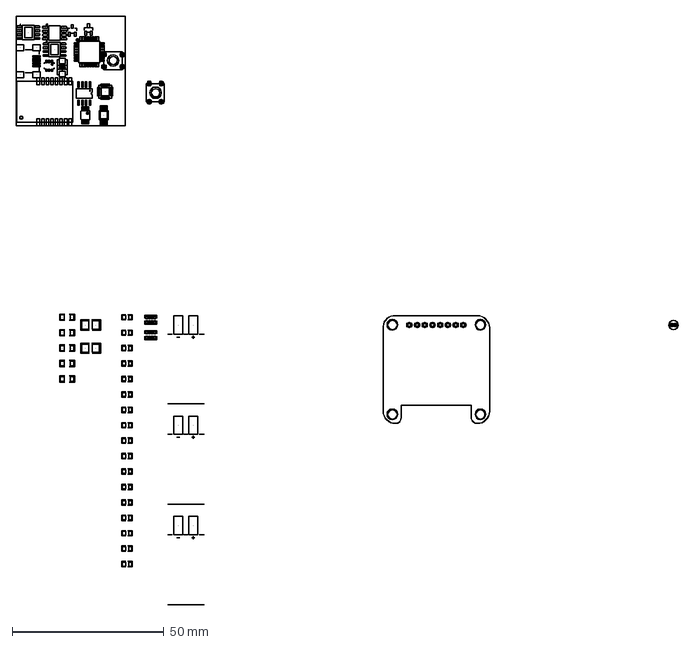
[picture p110: CAD file, 2020-10-05]
Version/D2/Board/New PCB/New PCB_2020-10-05_16-17-58.dxf
218.0 x 193.6 mm
