jakedrew/SmartWatch/Version/D2/Board/SmartWatch D2 PCB/SmartWatch D2 PCB_2020-10-05_16-55-36.dxf

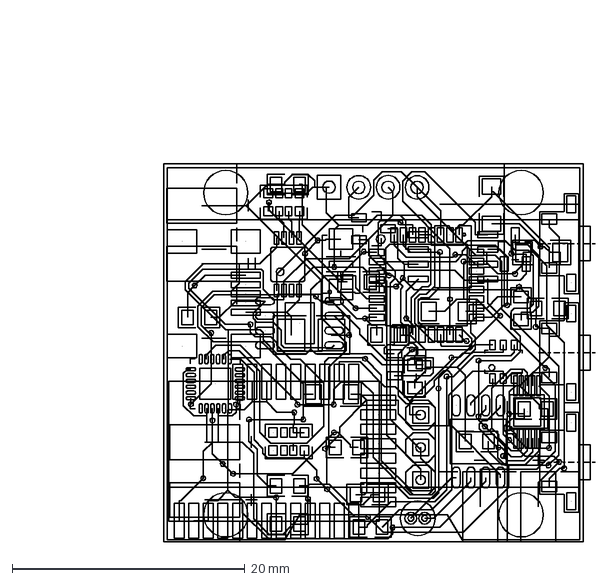
[picture p111: CAD file, 2020-10-05]
Version/D2/Board/SmartWatch D2 PCB/SmartWatch D2 PCB_2020-10-05_16-55-36.dxf
49.8 x 45.2 mm
