jakedrew/SmartWatch/Version/D4/Board/D4_2020-10-05_17-05-55.dxf

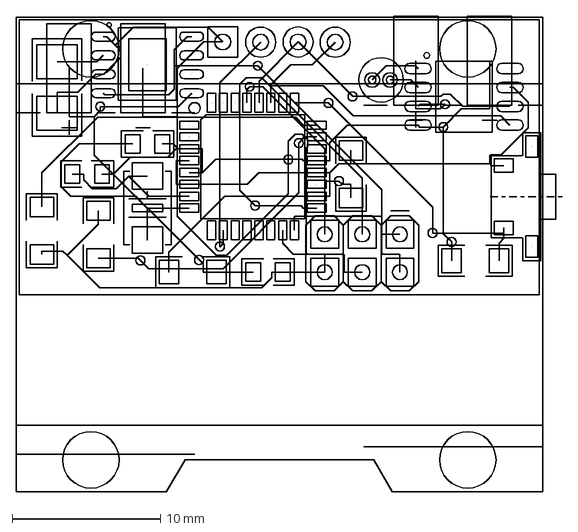
[picture p112: CAD file, 2020-10-05]
Version/D4/Board/D4_2020-10-05_17-05-55.dxf
36.8 x 32.1 mm
