jakedrew/SmartWatch/Version/D5/Board/D5 PCB_2020-10-05_19-07-10.dxf

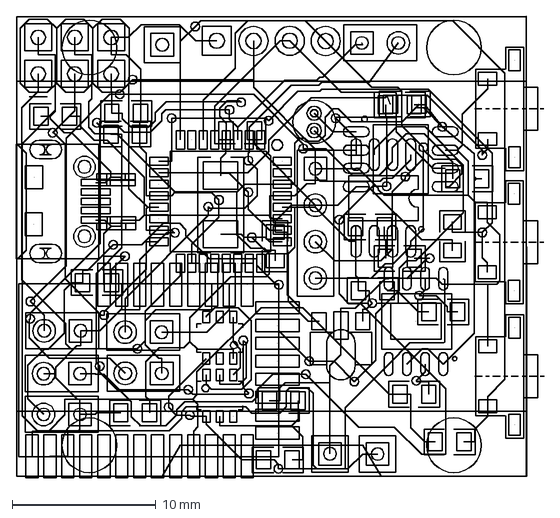
[picture p113: CAD file, 2020-10-05]
Version/D5/Board/D5 PCB_2020-10-05_19-07-10.dxf
36.8 x 32.1 mm
