jakedrew/SmartWatch/Version/D1/Board/V1/Gerber_V1_2020-10-05_14-34-46/How-to-order-PCB.txt

How to Order PCB

Please refer to:
https://docs.easyeda.com/en/PCB/Order-PCB
