jakedrew/SmartWatch/Version/D5/Board/Images/BottomSolderMaskLayer.png

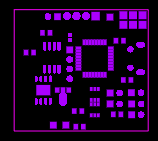
Version/D5/Board/Images/BottomSolderMaskLayer.png
