jakedrew/SmartWatch/Version/D5/Board/Images/TopSolderMaskLayer.png

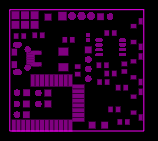
Version/D5/Board/Images/TopSolderMaskLayer.png
