jakedrew/SmartWatch/Version/D5/Schematic.pdf

+3V

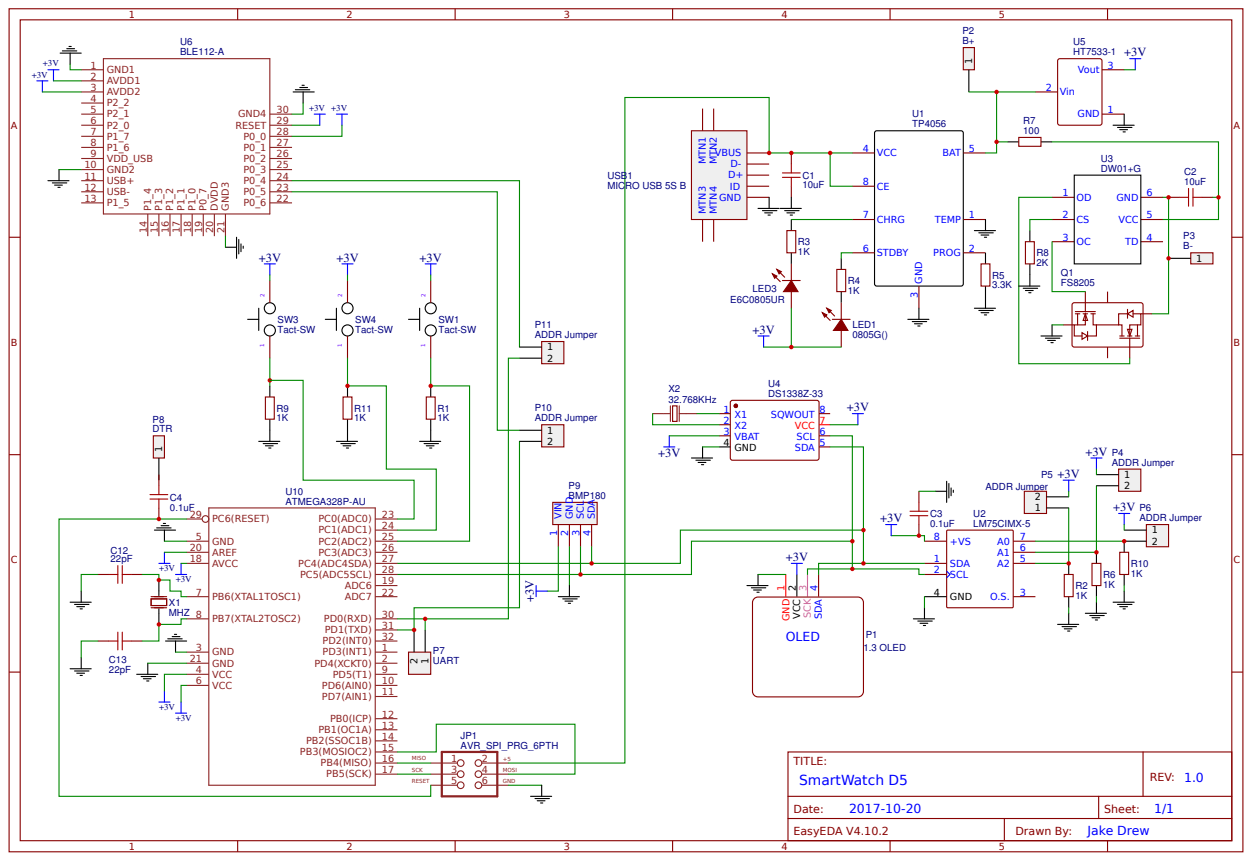
[picture p116: page 1]
