jakedrew/SmartWatch/Version/D1/Board/V1.1.pdf

+3V

+3V

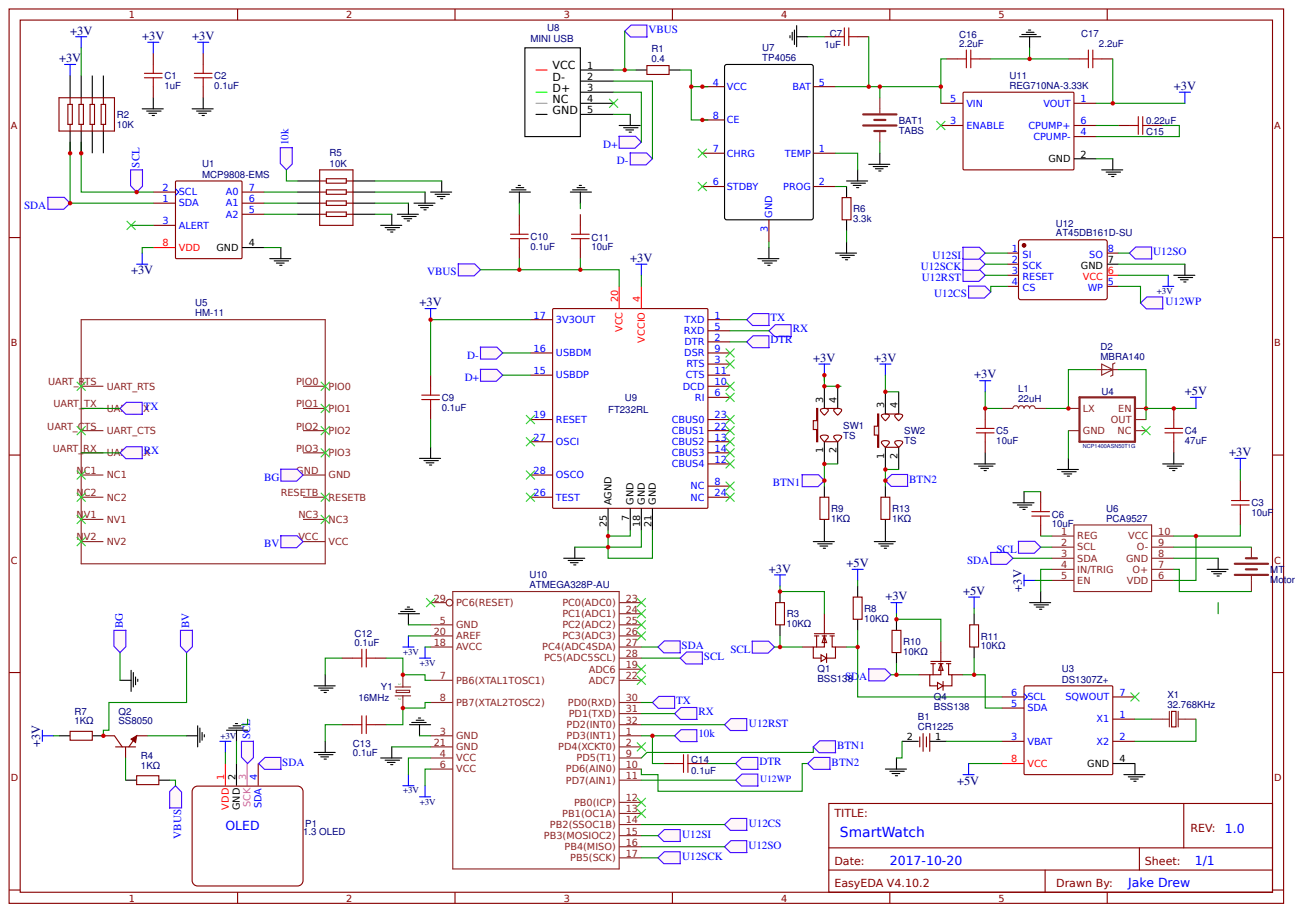
[picture p117: page 1]
