jakedrew/SmartWatch/Version/D2/Circuit/Schematic_D2_2020-10-05_16-14-51.pdf

## VCC

D-

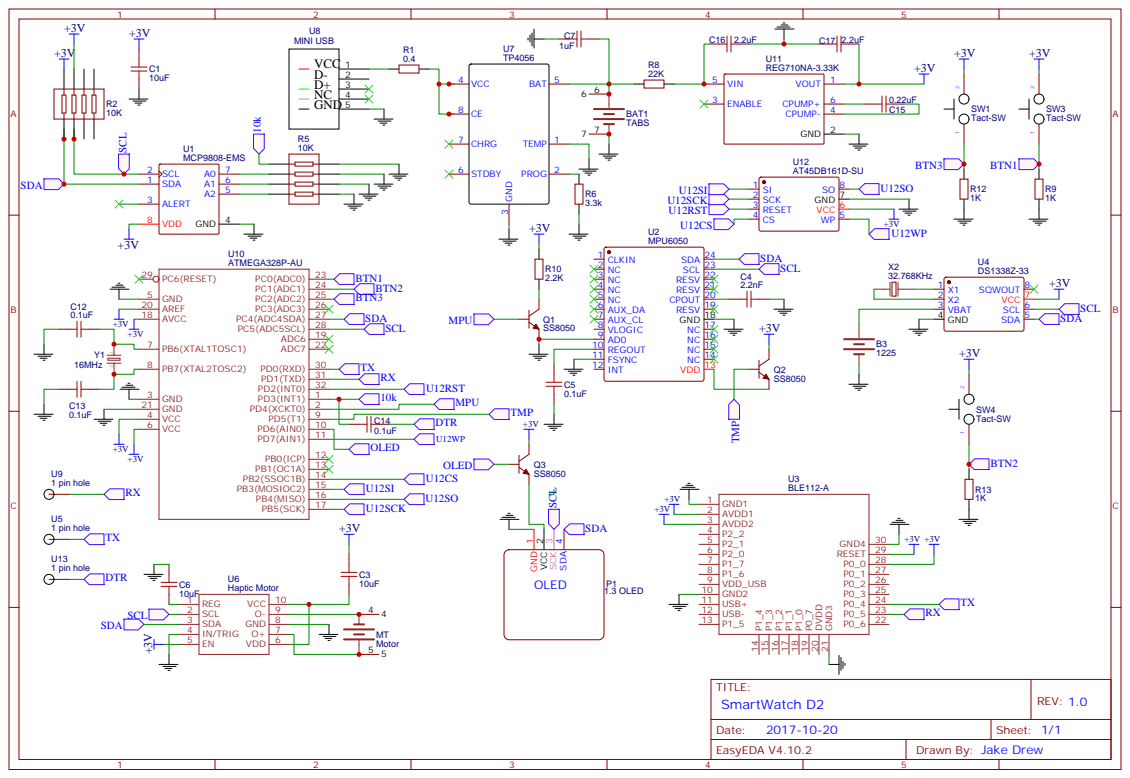
[picture p118: page 1]
