jakedrew/SmartWatch/Version/D4/Circuit/V4.1/Schematic_D4_2020-10-05_17-04-09.pdf

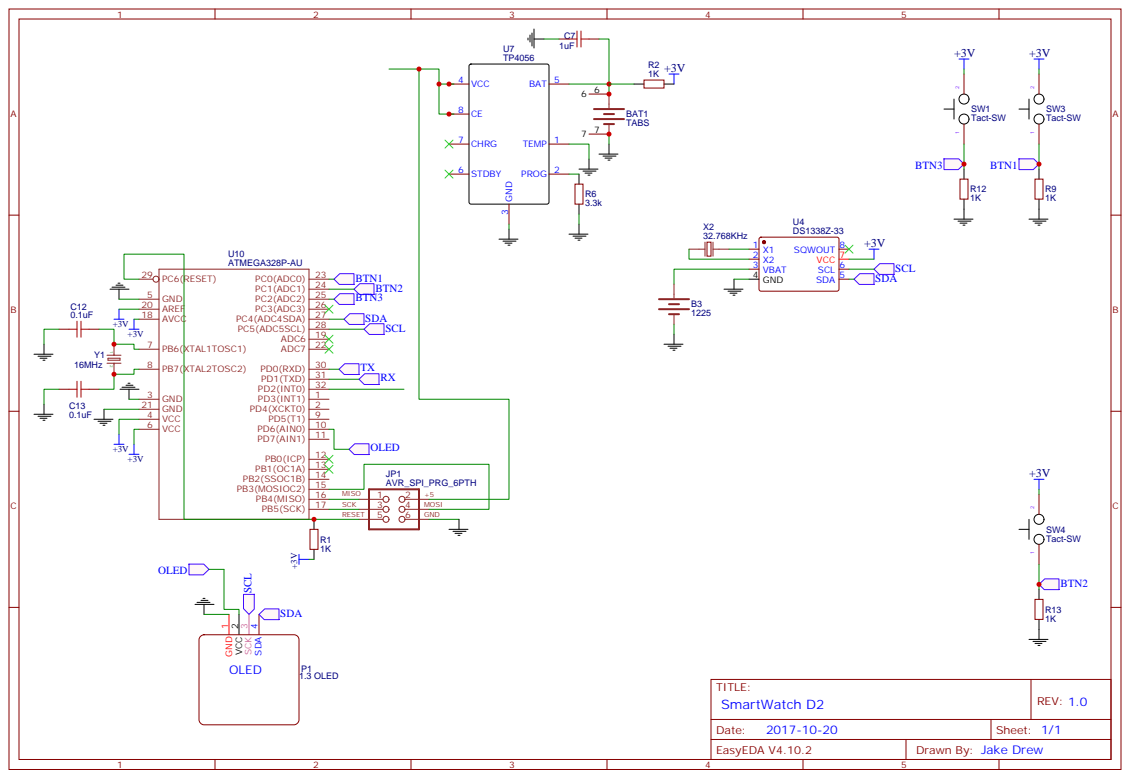
[picture p119: page 1]
