jakedrew/SmartWatch/Version/D5/Board/Images/BottomSolderMaskLayer.pdf

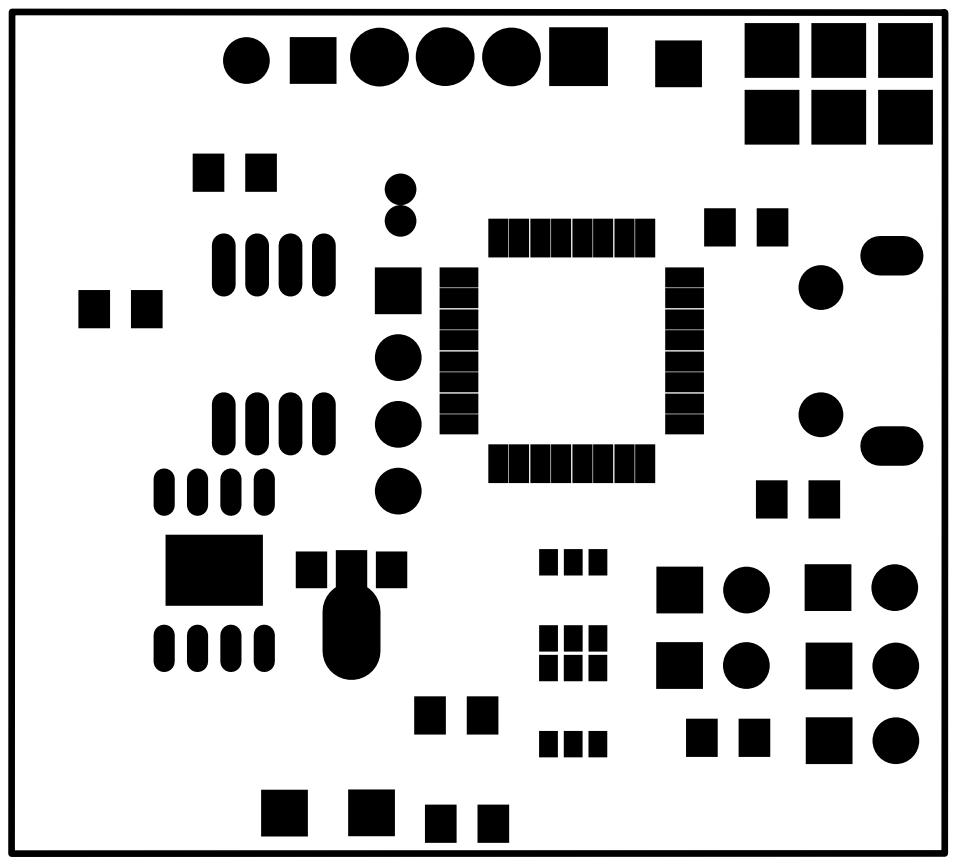
[picture p120: page 1]
