jakedrew/SmartWatch/Version/D5/Board/Images/TopSolderMaskLayer.pdf

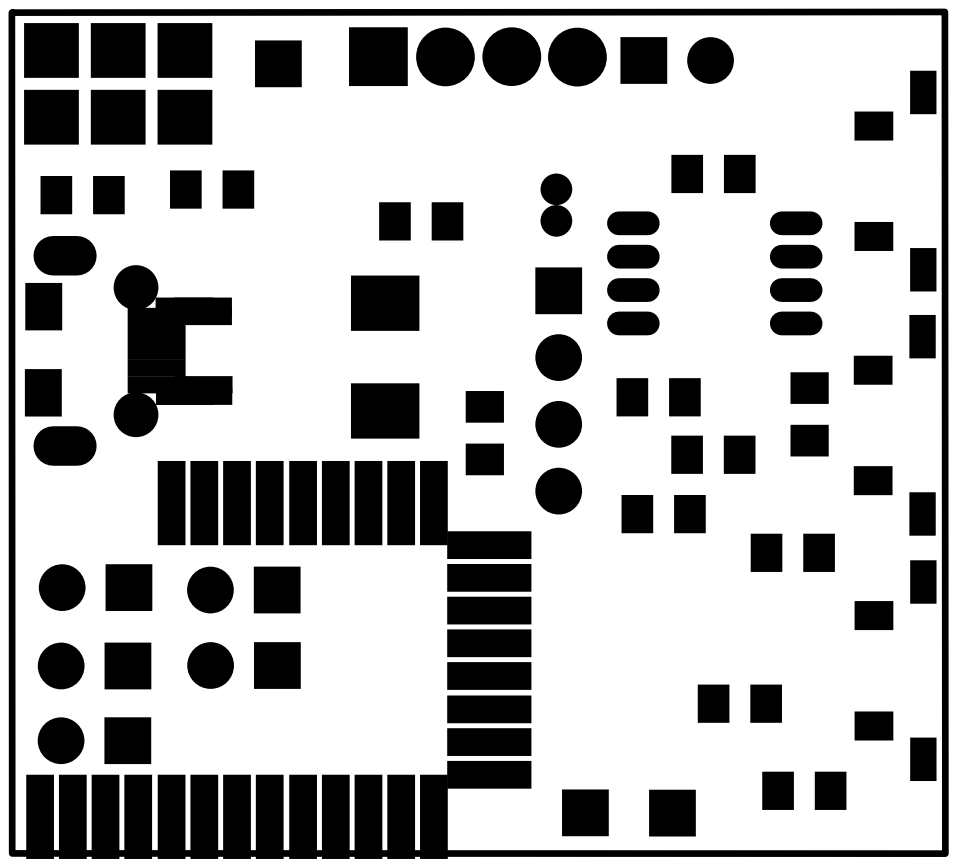
[picture p121: page 1]
