jakedrew/SmartWatch/Version/D1/Circuit/V1.1/Schematic_D1_2020-10-05_14-29-57.pdf

## VCC

D-

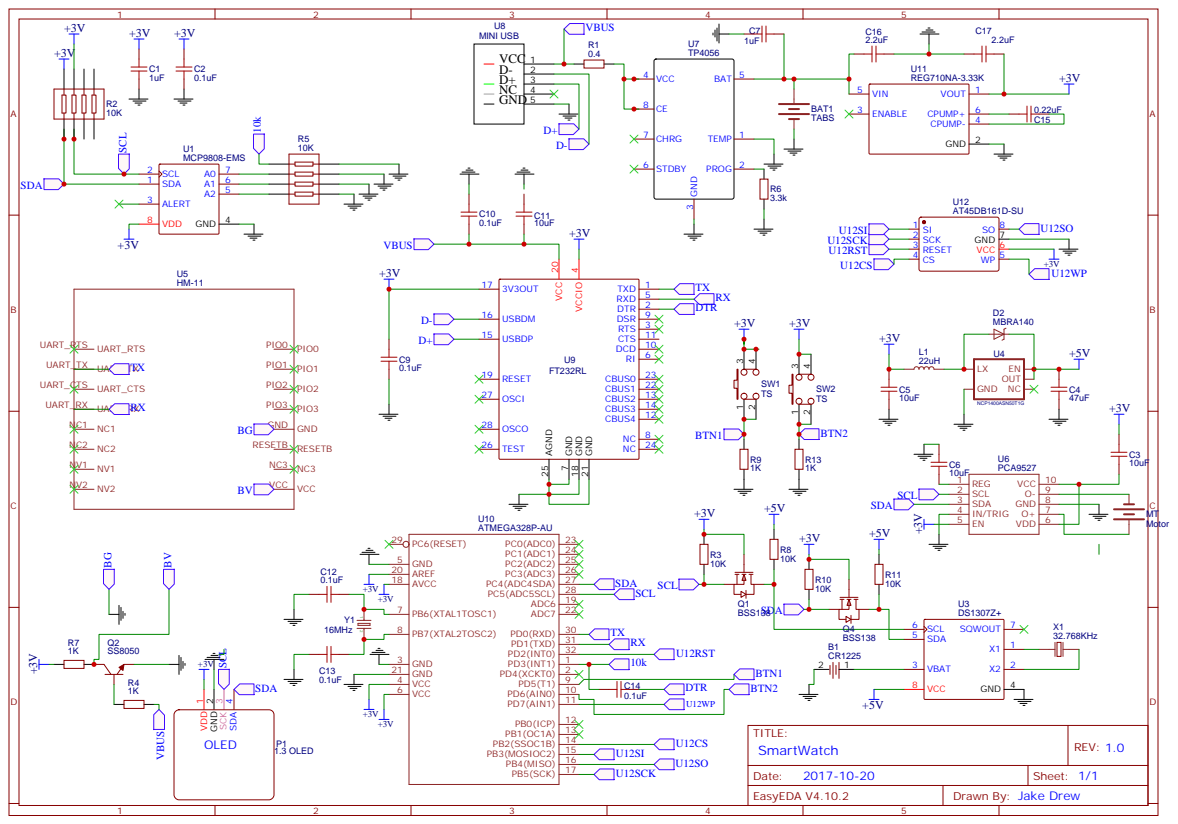
[picture p122: page 1]
