jakedrew/SmartWatch/Version/D4/Board/PCB_D4_2020-10-05_17-05-39.pdf

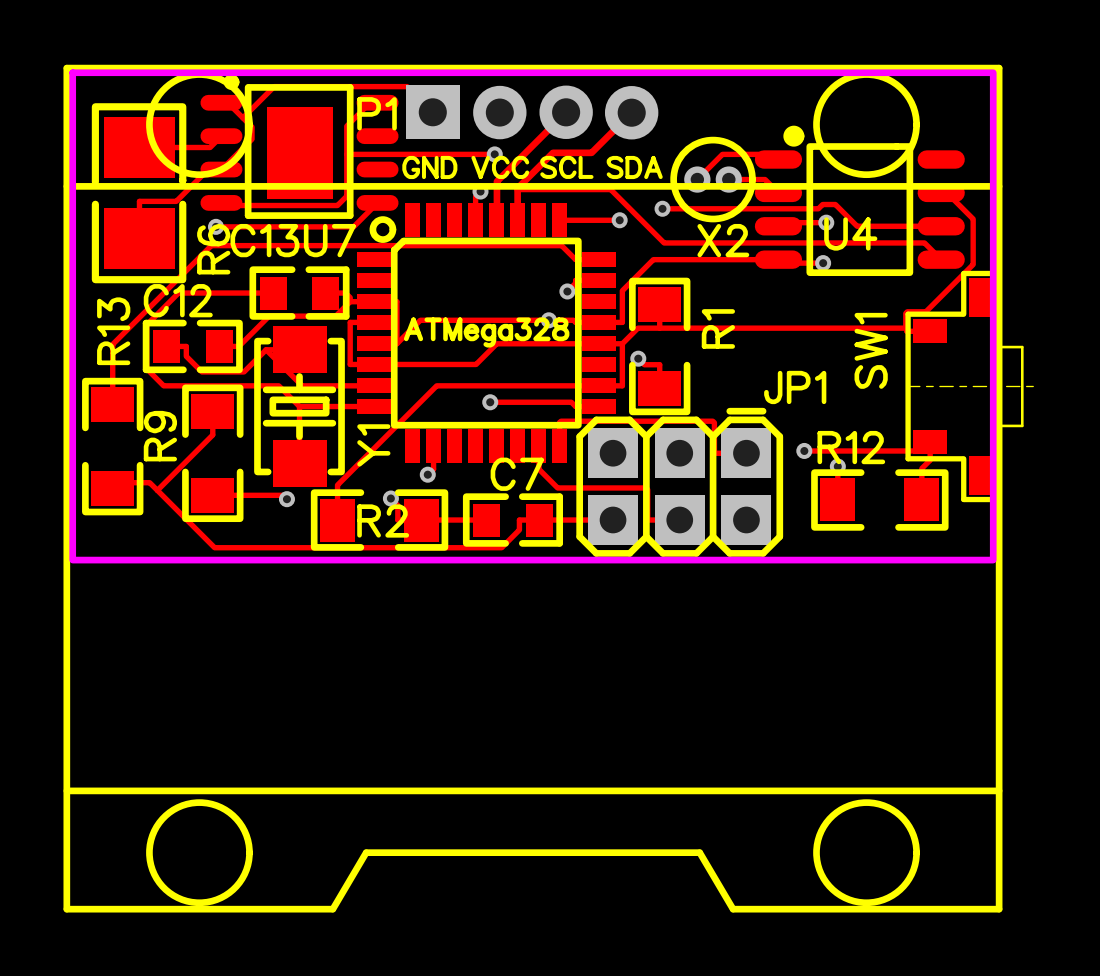
[picture p123: page 1]
