jakedrew/SmartWatch/Version/D5/Board/PCB_D5 PCB_2020-10-05_19-05-40.pdf

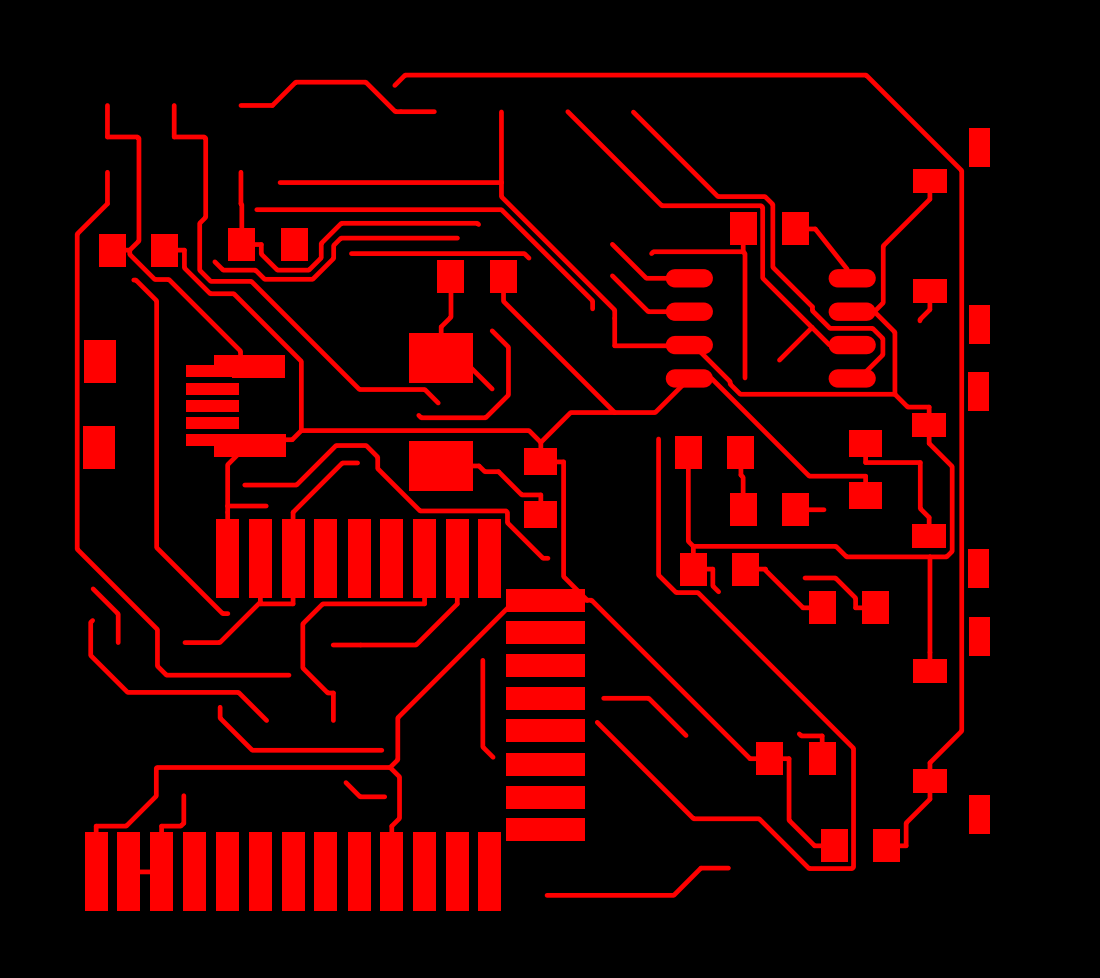
[picture p124: page 1]

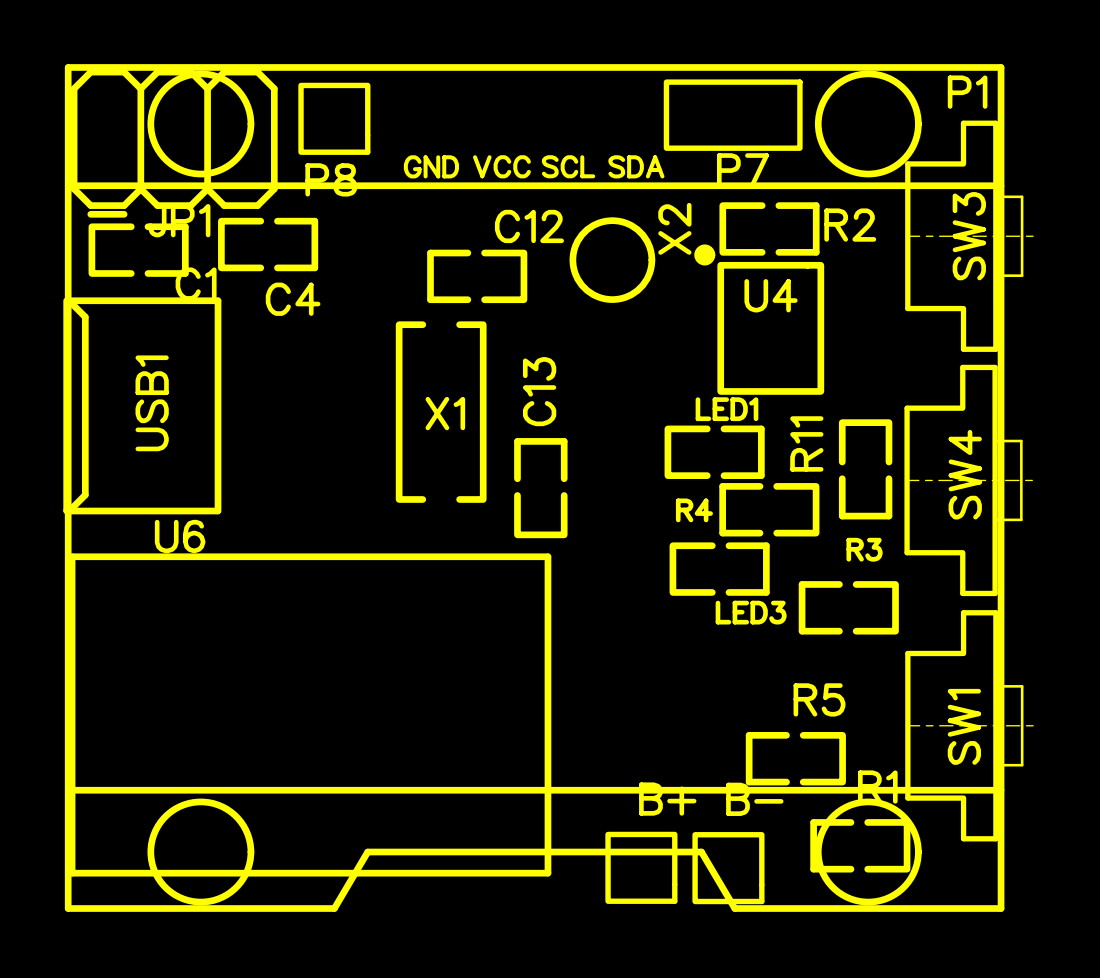
[picture p125: page 2]

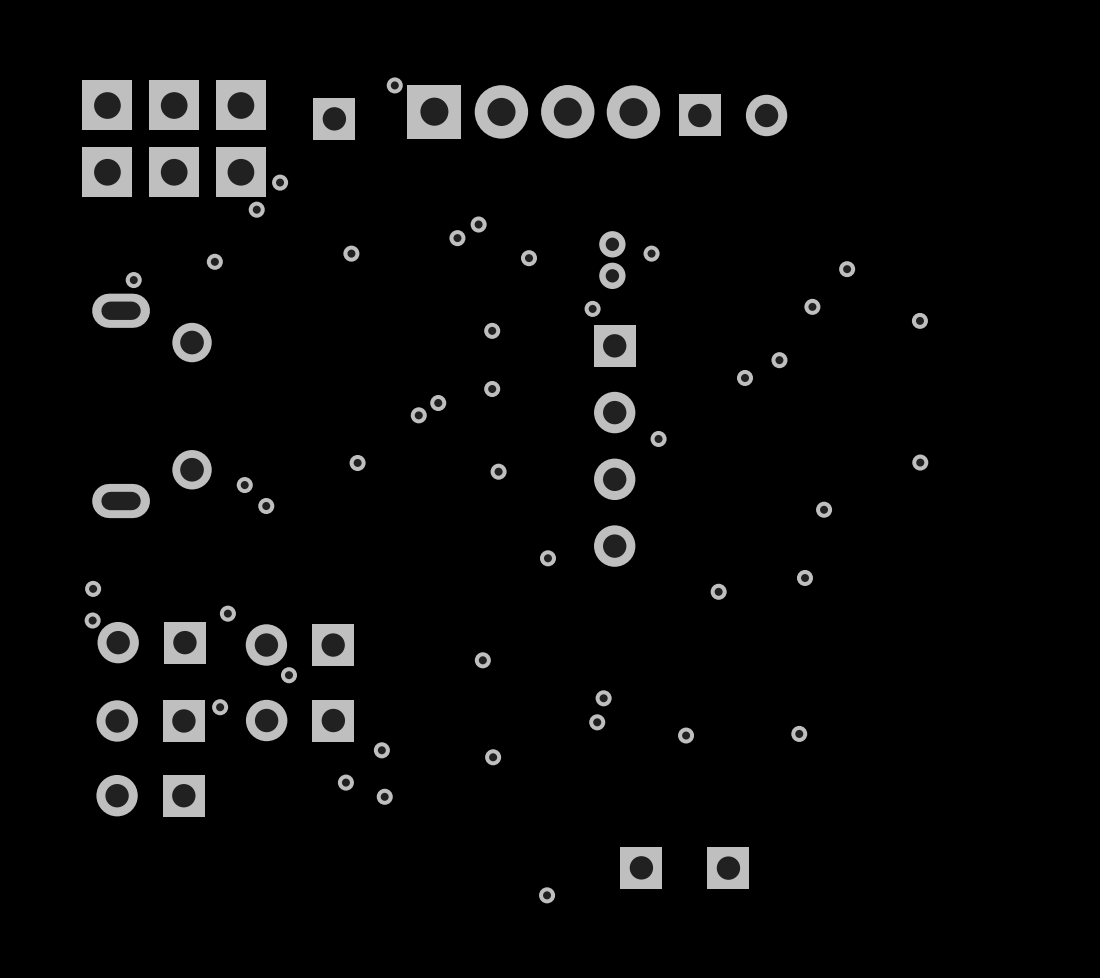
[picture p126: page 4]
