jakedrew/SmartWatch/Version/D1/Board/PCB Cropped Final.pdf

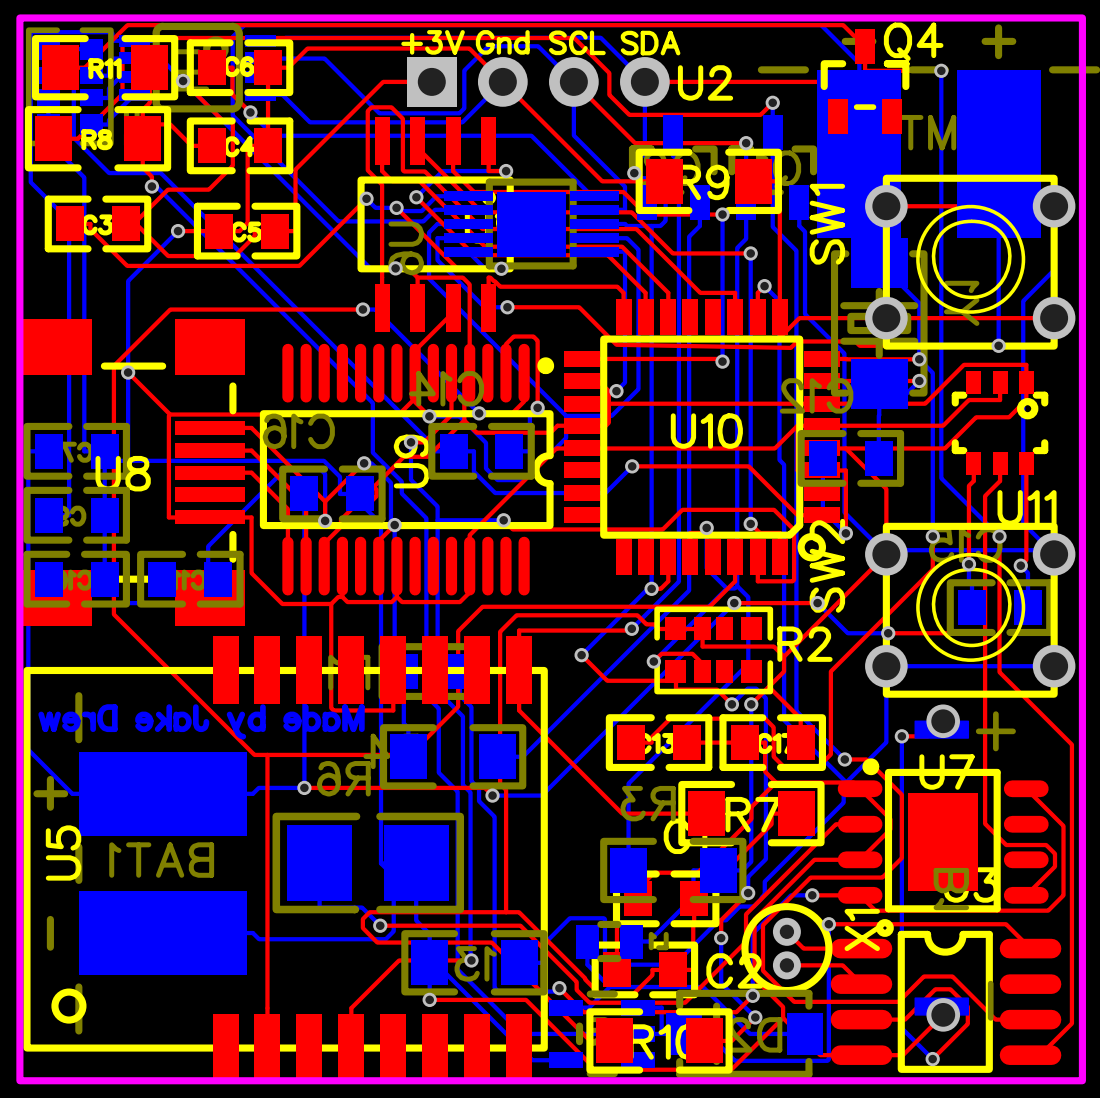
[picture p127: page 1]
