jakedrew/SmartWatch/Version/D1/Board/Fin/PCB_Fin_2020-10-05_16-09-56.pdf

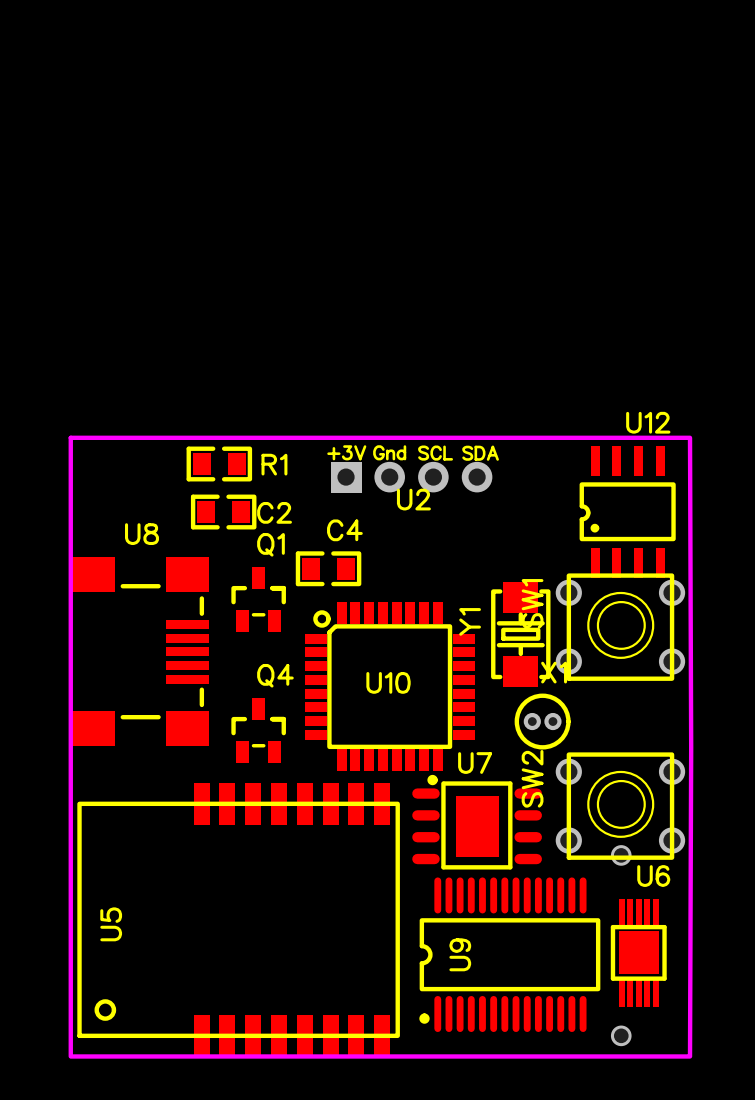
[picture p128: page 1]
