jakedrew/SmartWatch/Version/D1/Board/PCB Final/PCB_PCB Final_2020-10-05_16-11-37.pdf

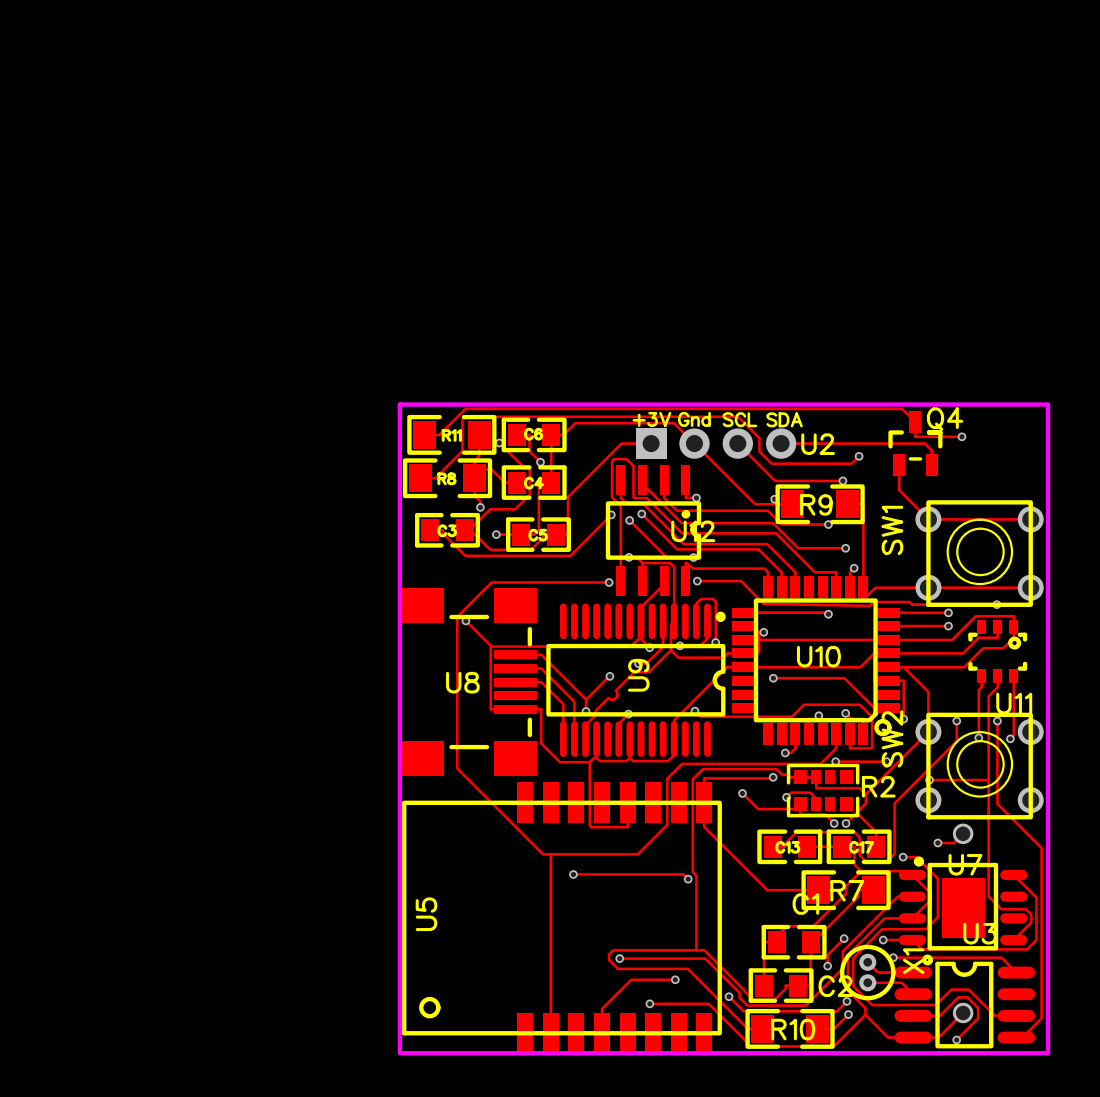
[picture p129: page 1]
