jakedrew/SmartWatch/Version/D2/Board/D2 PCB Final/PCB_D2 PCB Final_2020-10-05_16-49-25.pdf

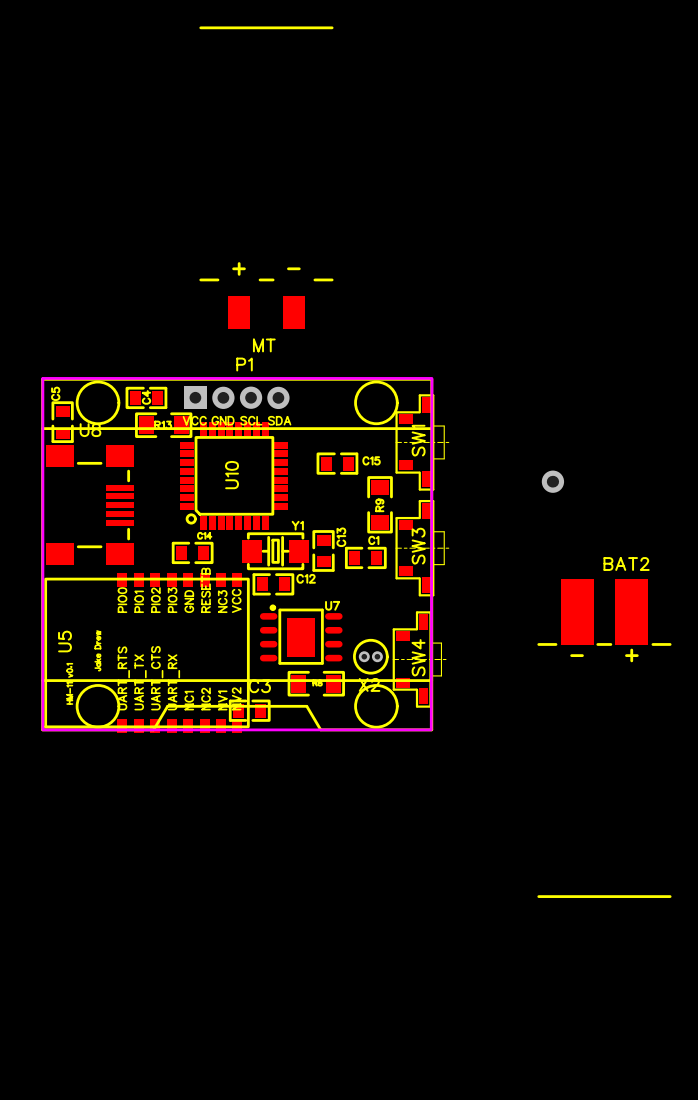
[picture p130: page 1]
