jakedrew/SmartWatch/Version/D2/Board/New PCB/PCB_New PCB_2020-10-05_16-16-31.pdf

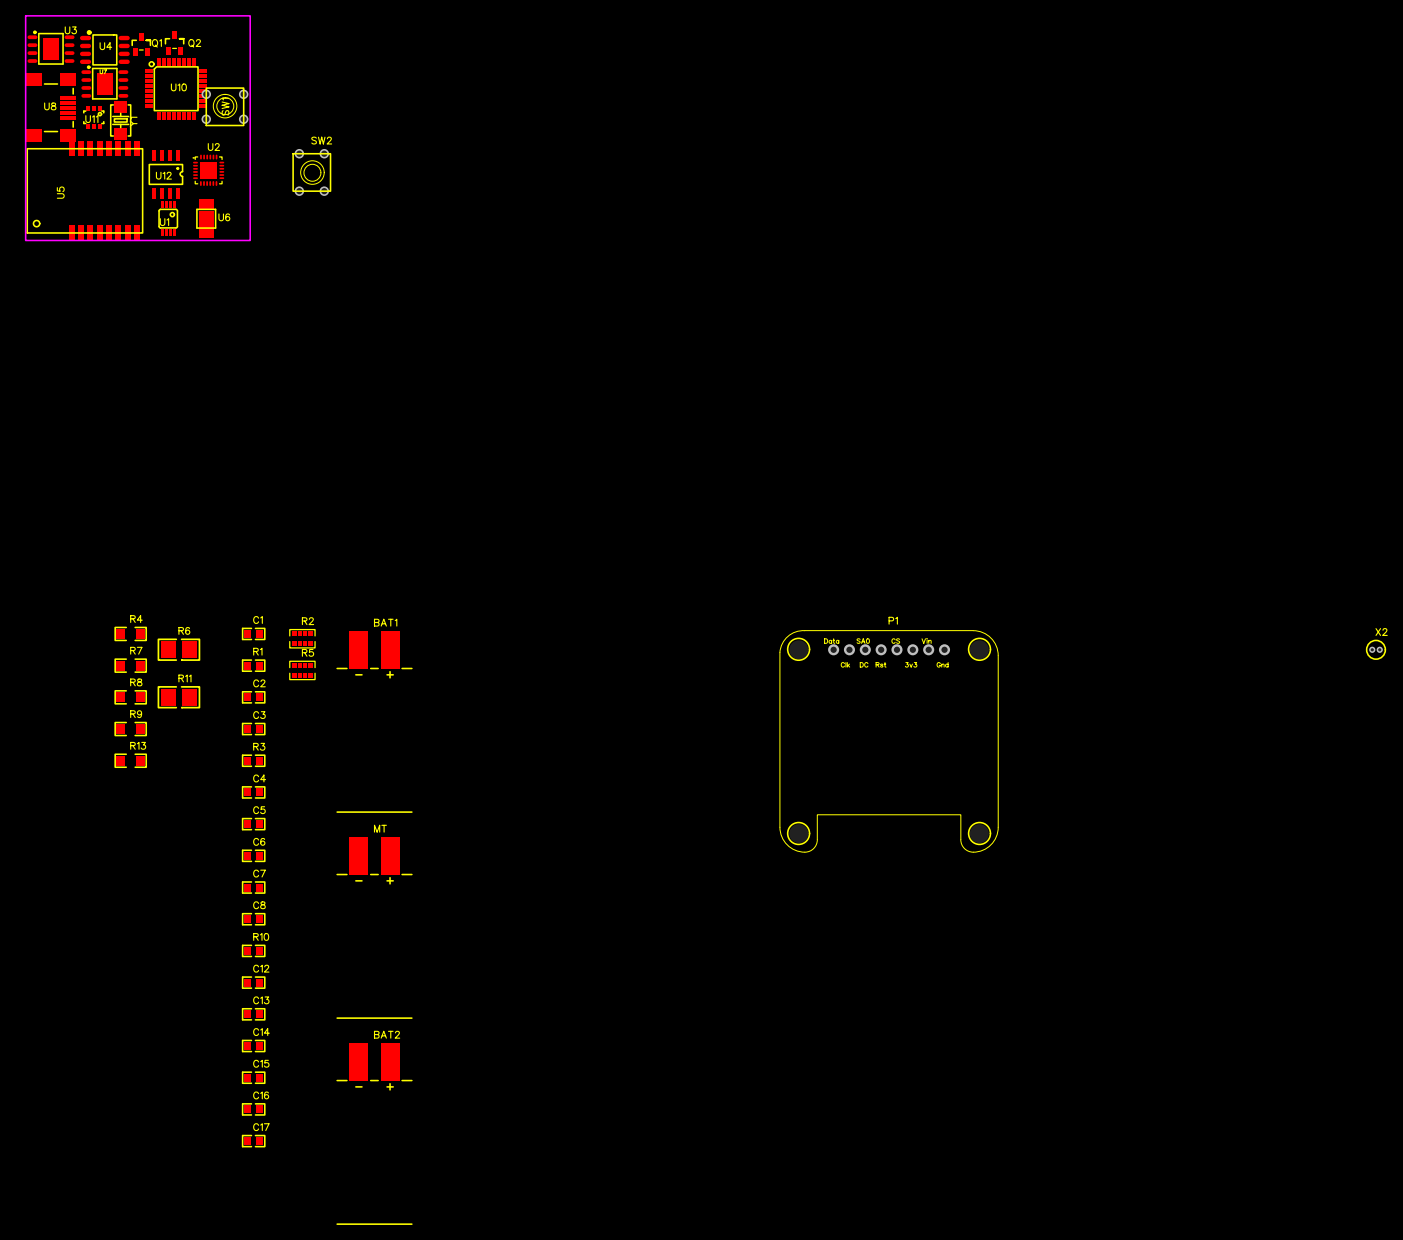
[picture p131: page 1]
