jakedrew/SmartWatch/Version/D3/Circuit/V4.1/V4.1.pdf

## VCC

D-

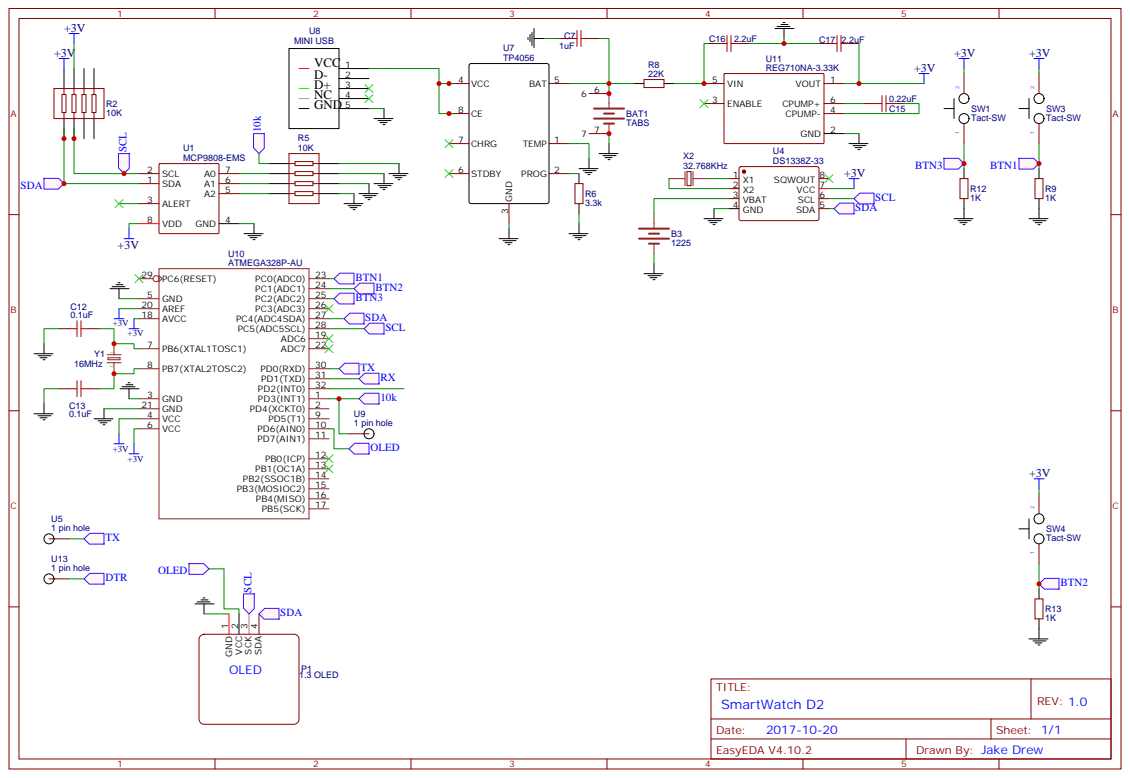
[picture p133: page 1]
