jakedrew/SmartWatch/Version/D5/Board/Images/BottomLayer.pdf

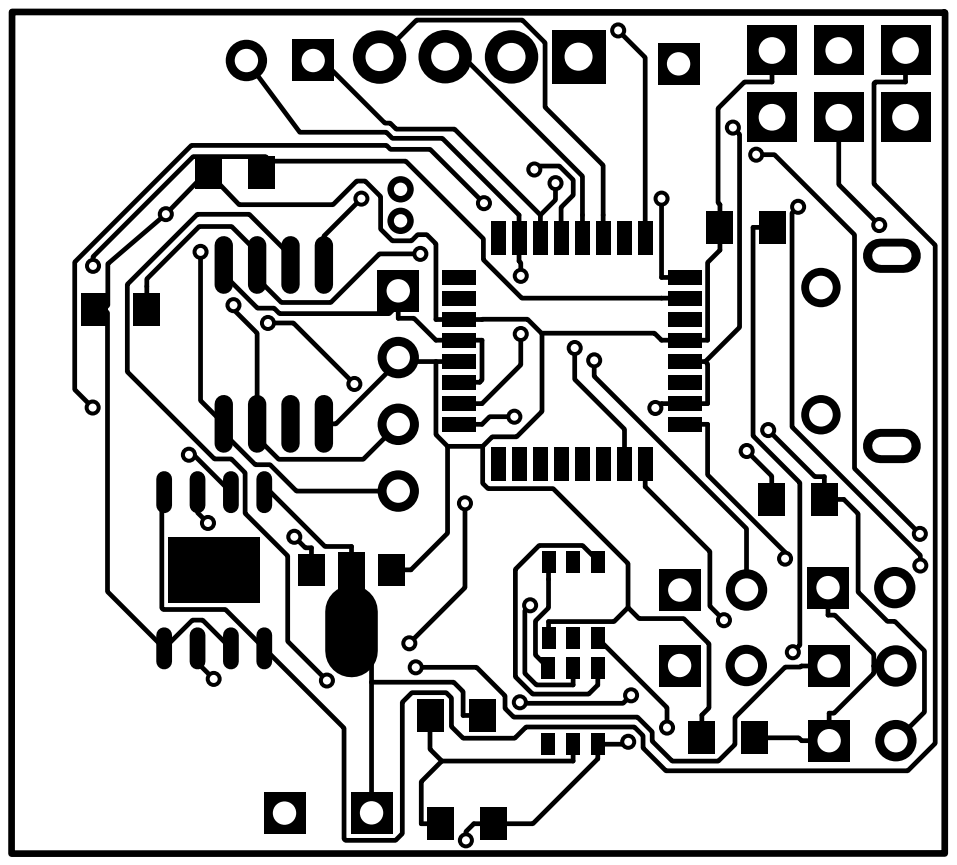
[picture p134: page 1]
