jakedrew/SmartWatch/Version/D5/Board/Images/BottomSilkLayer.pdf

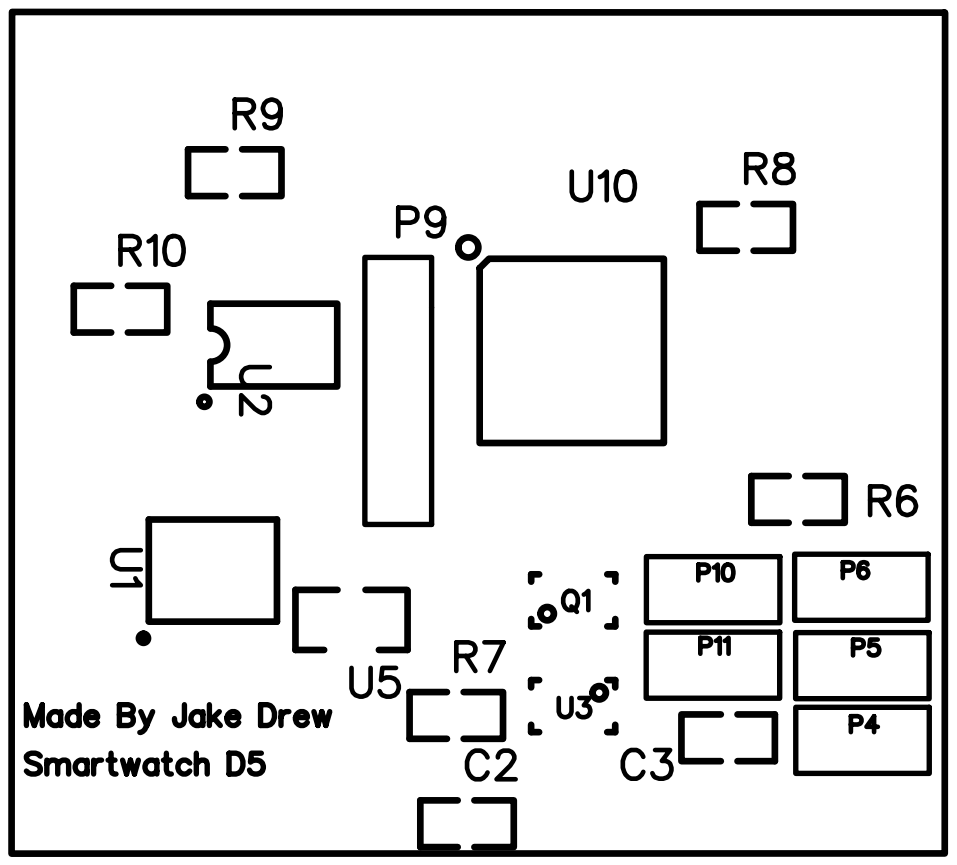
[picture p135: page 1]
