jakedrew/SmartWatch/Version/D5/Board/Images/Multi-Layer.pdf

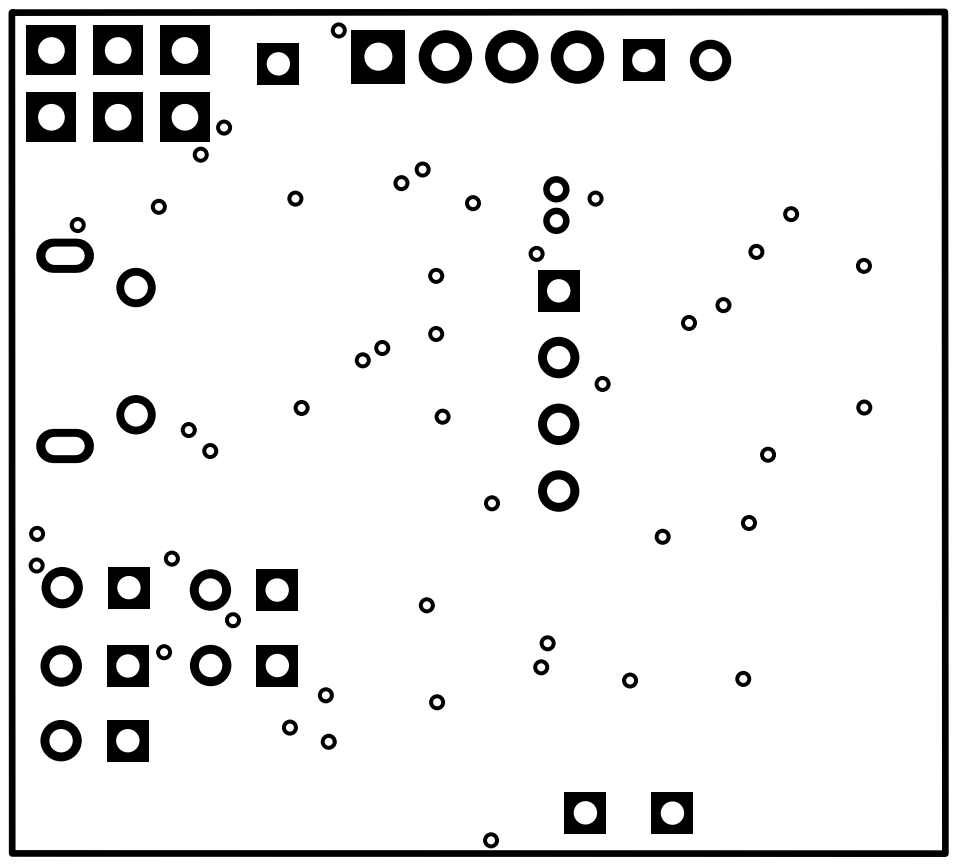
[picture p136: page 1]
