jakedrew/SmartWatch/Version/D5/Board/Images/TopLayer.pdf

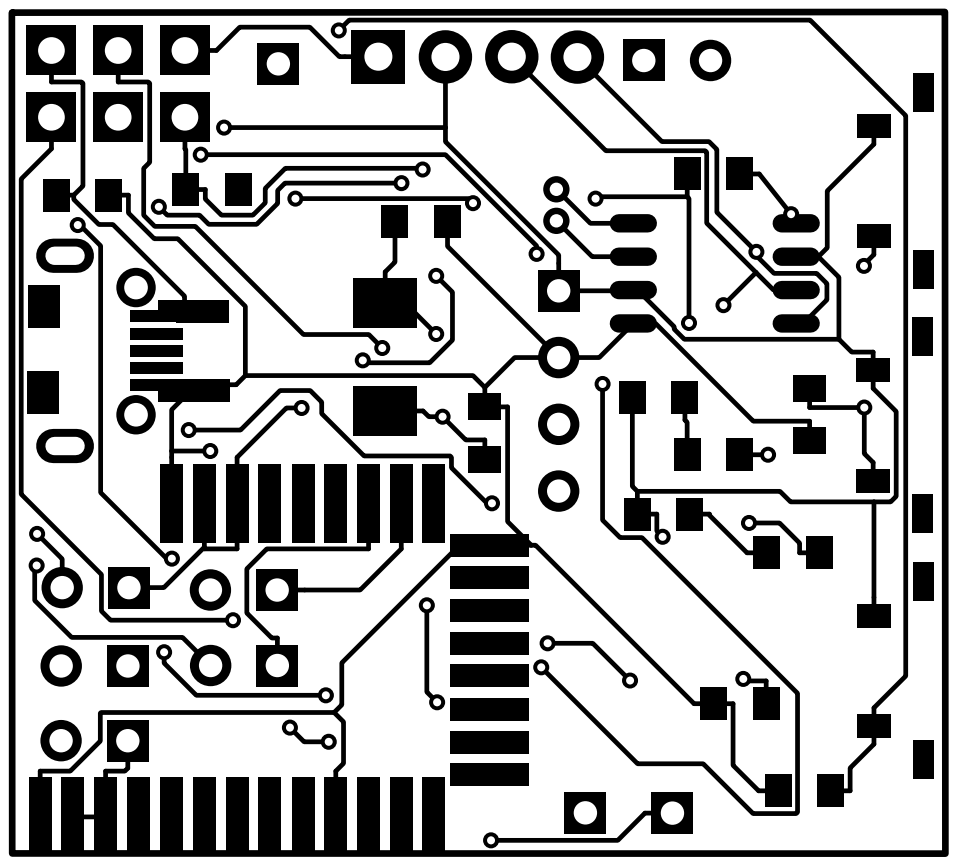
[picture p137: page 1]
