jakedrew/SmartWatch/Version/D5/Board/Images/TopSilkLayer.pdf

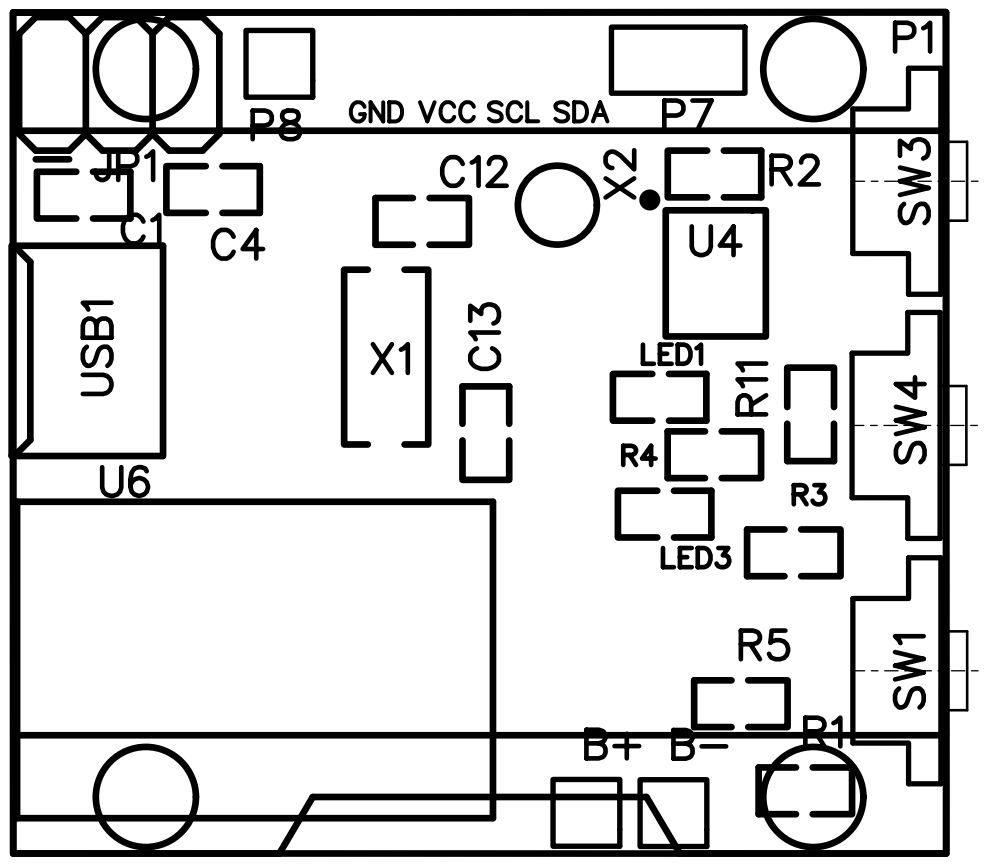
[picture p138: page 1]
