jakedrew/SmartWatch/Version/D5/Circuit/ADT75/ADT75.pdf

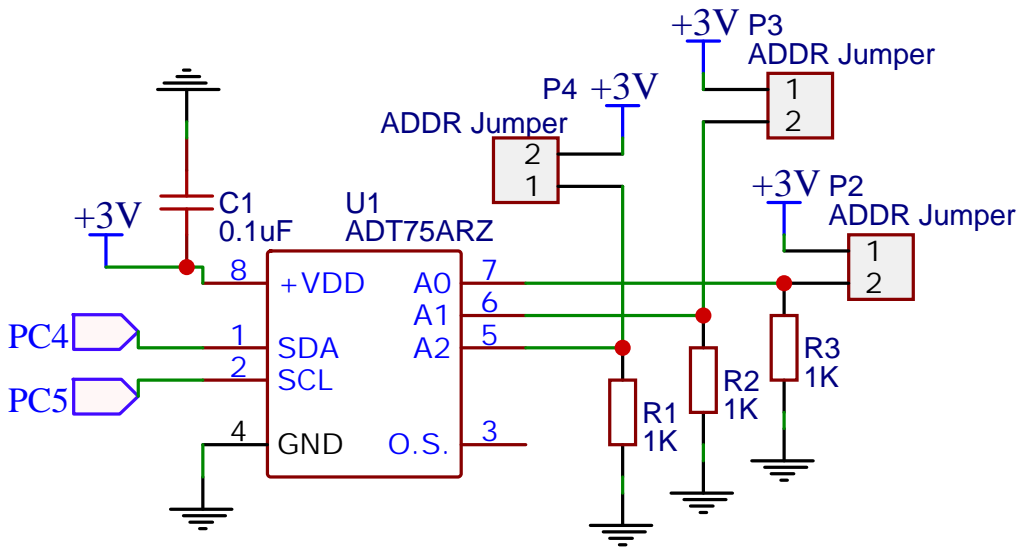
[picture p139: page 1]
