jakedrew/SmartWatch/Version/D5/Circuit/BMP180/BMP180.pdf

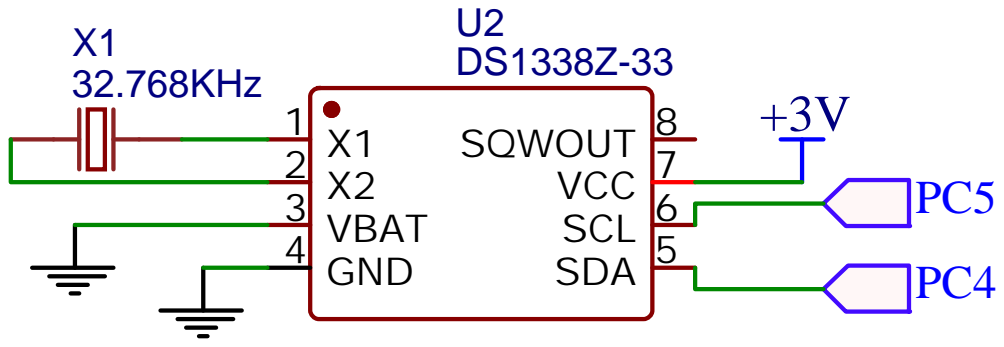
[picture p140: page 1]
