jakedrew/SmartWatch/Version/D5/Circuit/DS1338/DS1338.pdf

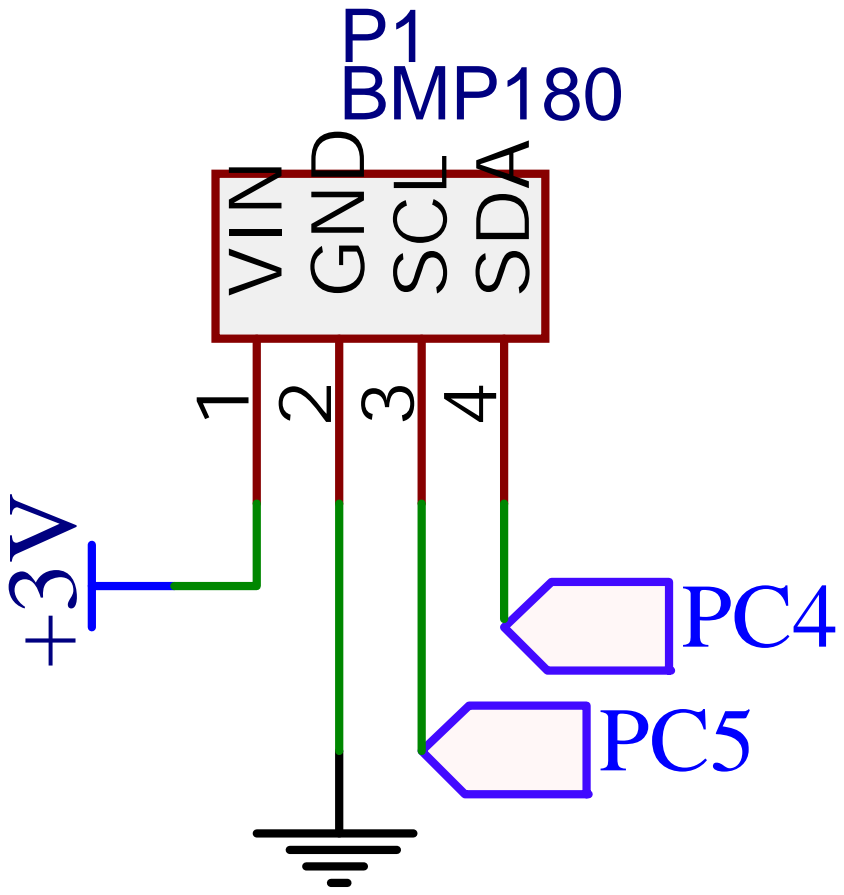
[picture p141: page 1]
