jakedrew/SmartWatch/Version/D5/Circuit/OLED/OLED.pdf

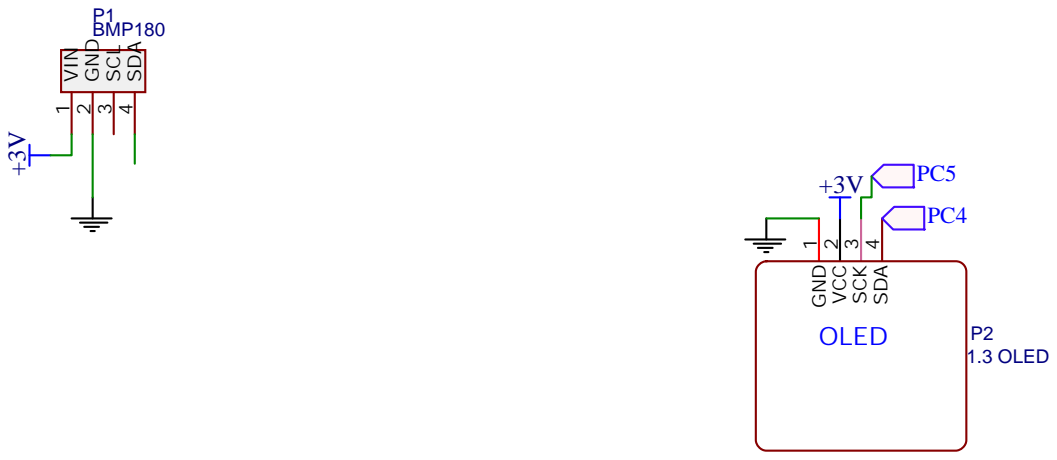
[picture p142: page 1]
