jakedrew/SmartWatch/Version/D5/Circuit/Power management/Power management.pdf

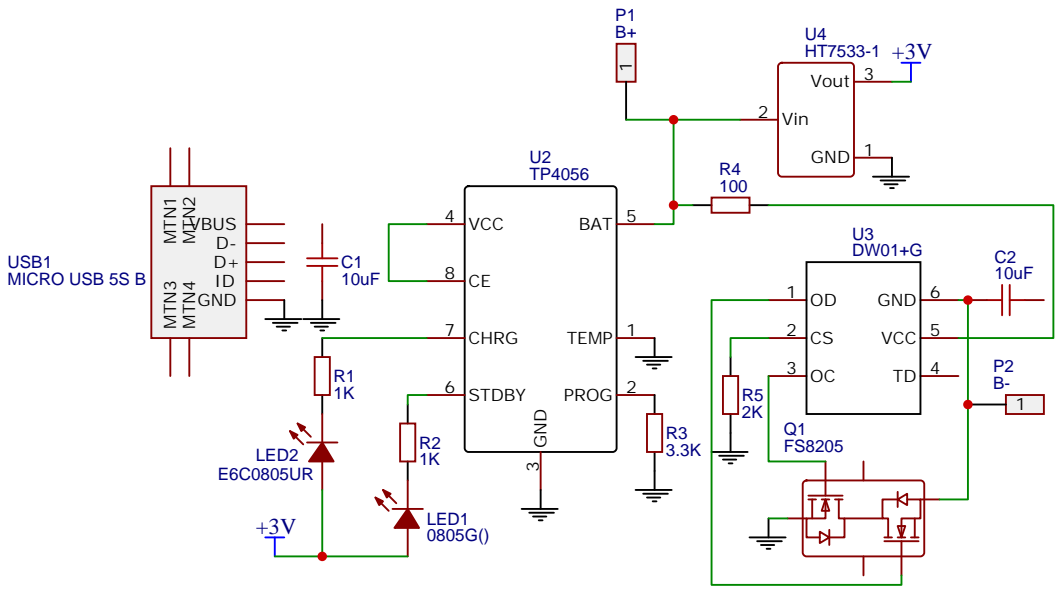
[picture p143: page 1]
