jakedrew/SmartWatch/Version/D5/Circuit/V5/V5.pdf

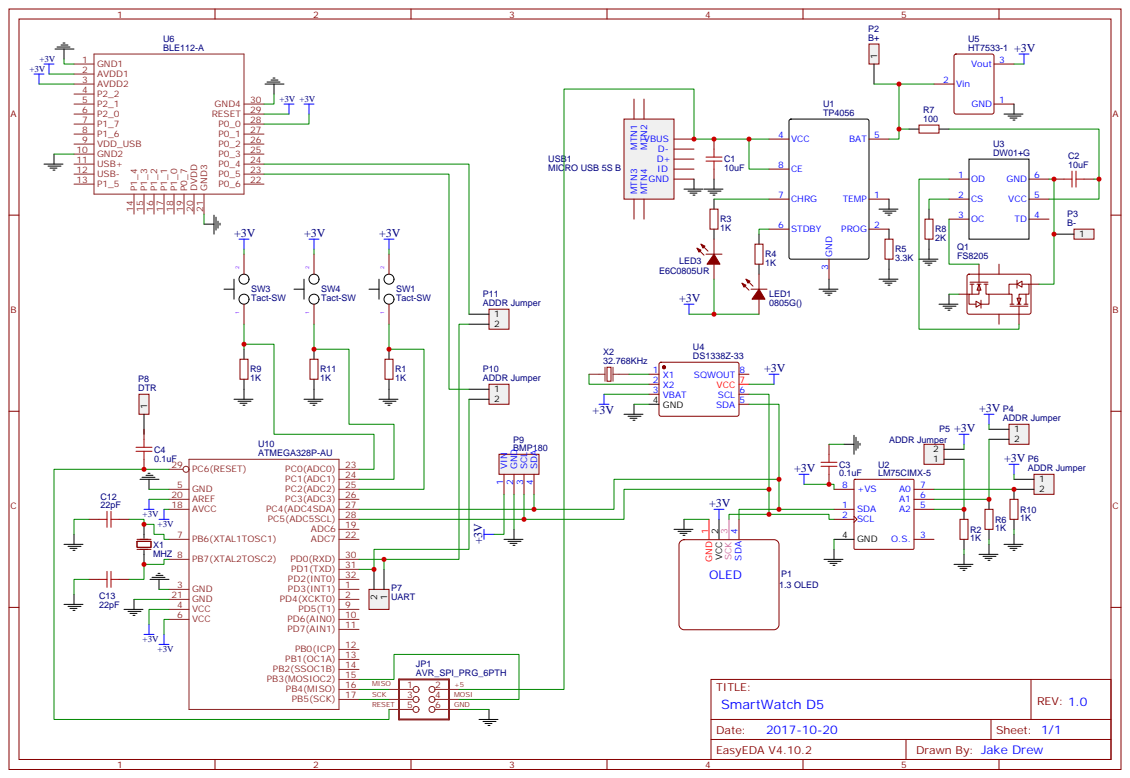
[picture p144: page 1]
