jakedrew/SmartWatch/Version/D1/Board/PCB1/PCB_PCB1_2020-10-05_14-45-12.pdf

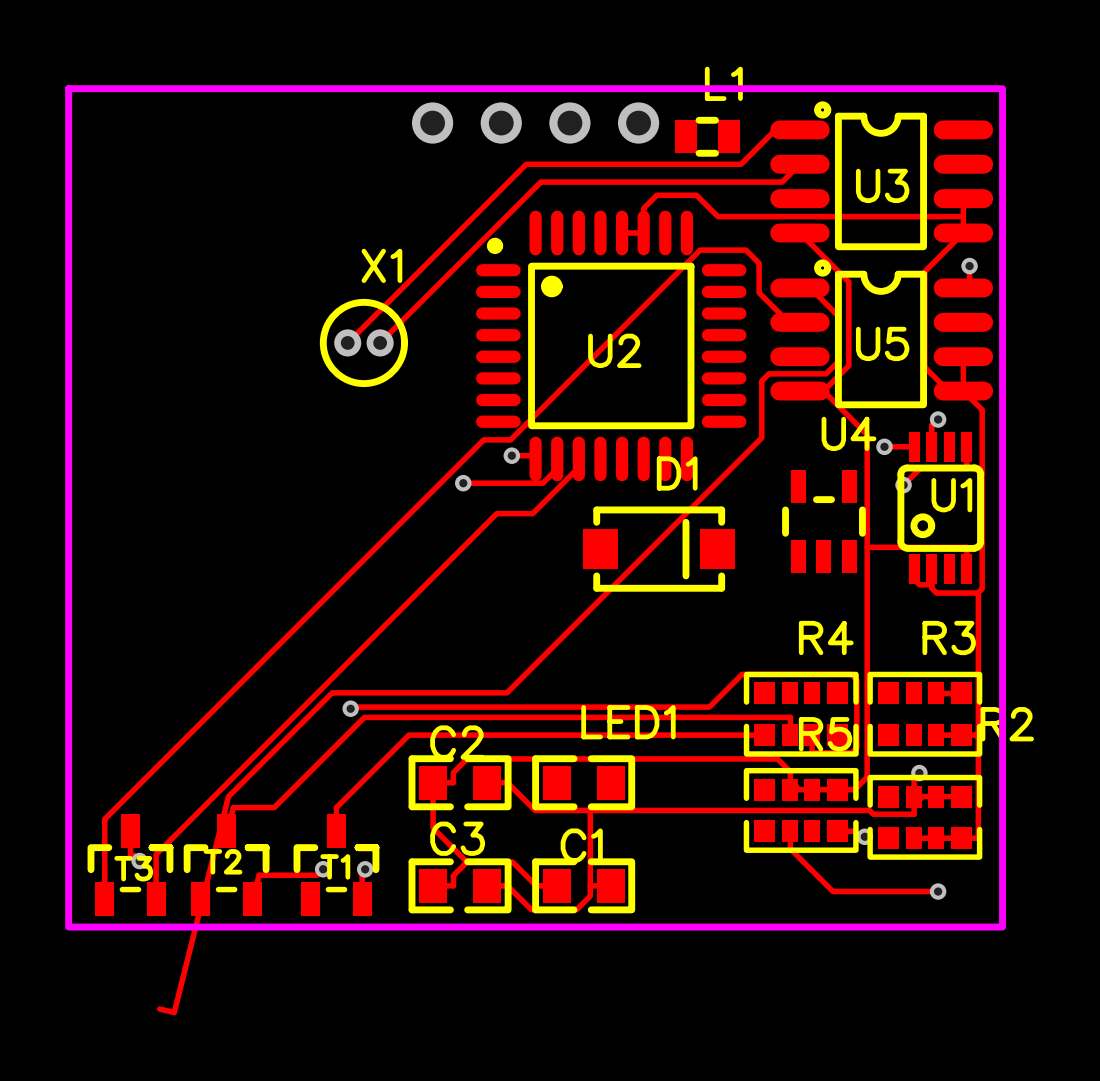
[picture p146: page 1]
