jakedrew/SmartWatch/Version/D1/Board/V1.pdf

+3V
+3V

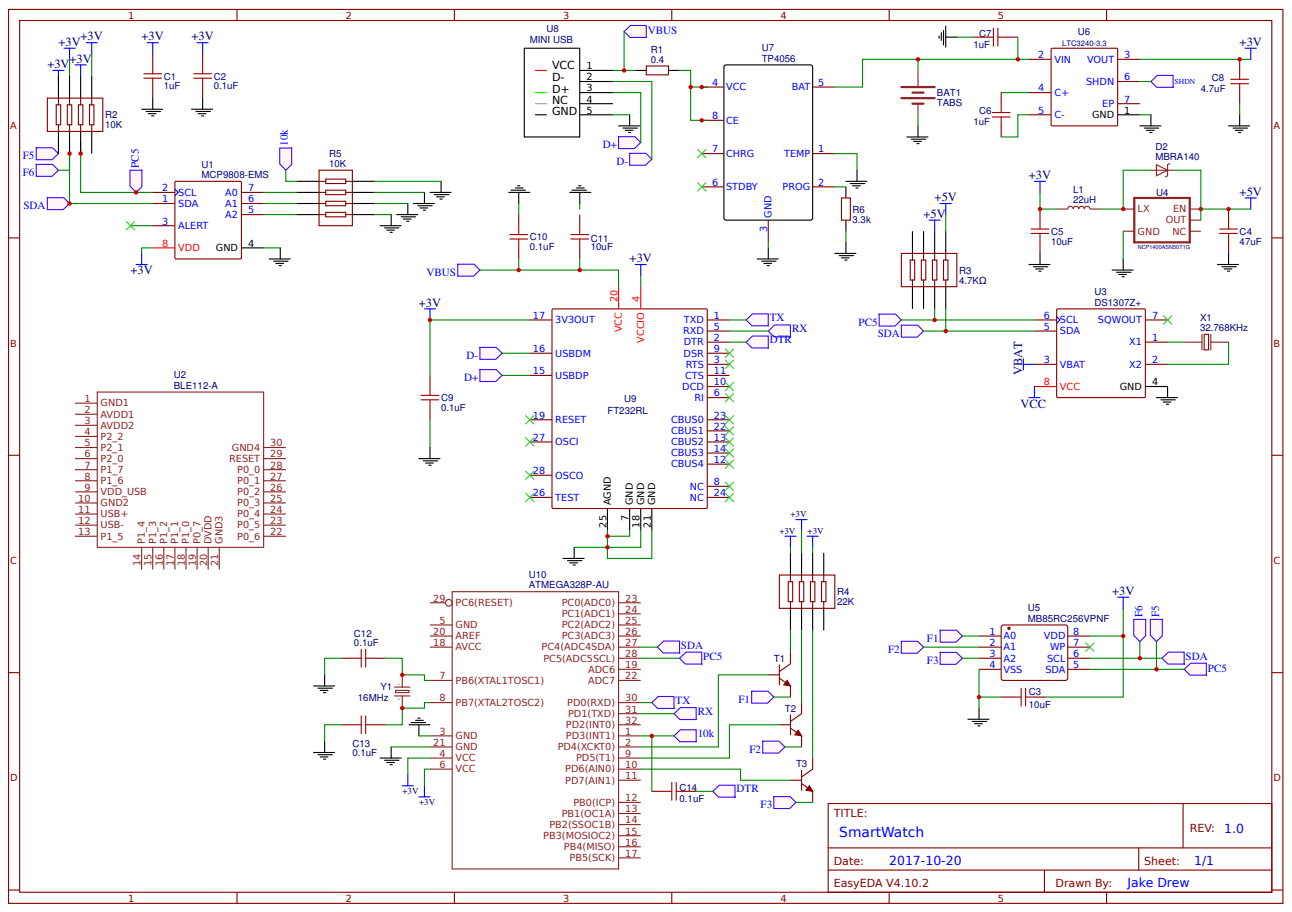
[picture p147: page 1]
