jakedrew/SmartWatch/Version/D3/Circuit/V3.1/V3.1.pdf

## VCC

D-

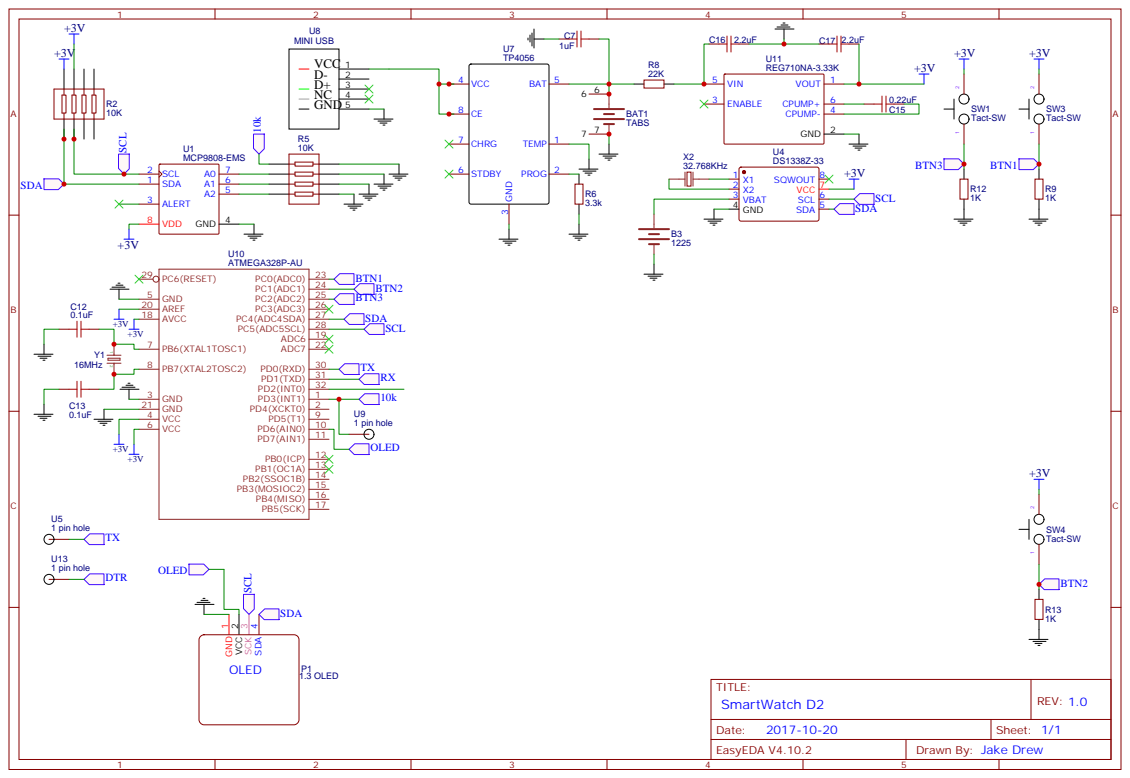
[picture p148: page 1]
