jakedrew/SmartWatch/Version/D5/Circuit/V5 copy/V5 copy.pdf

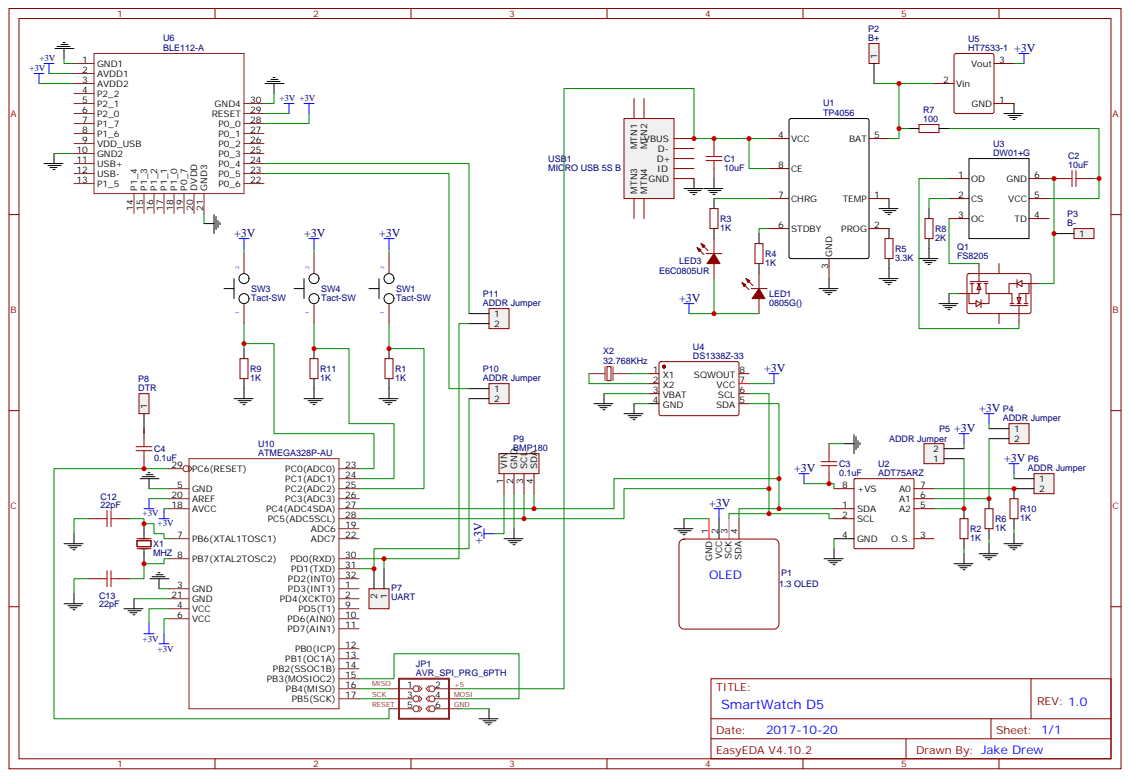
[picture p149: page 1]
