jakedrew/SmartWatch/(list of files, drawings)

Other design files:
Version/D1/Board/PCB Final/PCB Final_2020-10-05_16-12-15.json
Version/D1/Circuit/V1.1/V1.1_2020-10-05_14-30-43.schdoc
Version/D2/Circuit/V2.1_2020-10-05_16-15-18.schdoc
Version/D3/Circuit/V3.1/V3.1.schdoc
Version/D3/Circuit/V4.1/V4.1.schdoc
Version/D4/Circuit/V4.1/V4.1_2020-10-05_17-04-51.schdoc
Version/D5/Circuit/ADT75/ADT75.schdoc
Version/D5/Circuit/BMP180/BMP180.schdoc
Version/D5/Circuit/DS1338/DS1338.schdoc
Version/D5/Circuit/OLED/OLED.schdoc
Version/D5/Circuit/Power management/Power management.schdoc
Version/D5/Circuit/V5 copy/V5 copy.schdoc
Version/D5/Circuit/V5/V5.schdoc
