jakedrew/SmartWatch/Codebase/Test Sketches/sketch_jul21c/sketch_jul21c.ino

String incomingByte = "";   // for incoming serial data

void setup() {
        Serial.begin(9600);     // opens serial port, sets data rate to 9600 bps
}

void loop() {

        // send data only when you receive data:
        if (Serial.available() > 0) {
                // read the incoming byte:
                incomingByte = Serial.readString();

                // say what you got:
                Serial.print("I received: ");
                Serial.println(incomingByte);
        }
}
