jakedrew/SmartWatch/Codebase/Test Sketches/sketch_jul25e/sketch_jul25e.ino

// Date and time functions using just software, based on millis() & timer

#include <Arduino.h>
#include <Wire.h>         // this #include still required because the RTClib depends on it
#include "RTClib.h"


RTC_DS1307 rtc;

void setup () {
    Serial.begin(9600);
    // following line sets the RTC to the date & time this sketch was compiled
    rtc.adjust(DateTime(__DATE__,__TIME__));
    // This line sets the RTC with an explicit date & time, for example to set
    // January 21, 2014 at 3am you would call:
    // rtc.adjust(DateTime(2014, 1, 21, 3, 0, 0));
}

void loop () {
    DateTime now = rtc.now();
    
    Serial.print(now.year(), DEC);
    Serial.print('/');
    Serial.print(now.month(), DEC);
    Serial.print('/');
    Serial.print(now.day(), DEC);
    Serial.print(' ');
    Serial.print(now.hour(), DEC);
    Serial.print(':');
    Serial.print(now.minute(), DEC);
    Serial.print(':');
    Serial.print(now.second(), DEC);
    Serial.println();
    
    Serial.print(" seconds since 1970: ");
    Serial.println(now.unixtime());
    
    delay(3000);
}
