jakedrew/SmartWatch/(commit log)

2017-09-26 retrieve_api()
    The function retrieve_api() has been populated to utilise the ip-api.com/csv/ api to retrieve relevant information about the device.
2017-11-09 Create gerber
2017-11-09 (+) D1 Gerber Files
    [Gerber_drill.GBL, Gerber_drill.GBO, Gerber_drill.GBP, Gerber_drill.GBS, Gerber_drill.GKO, Gerber_drill.GTL, Gerber_drill.GTO, Gerber_drill.GTP]
2018-01-04 (+) Version 5 of the Schematic and the Gerber file
    [Gerber_drill.GBL, Gerber_drill.GBO, Gerber_drill.GBP, Gerber_drill.GBS, Gerber_drill.GKO, Gerber_drill.GTL, Gerber_drill.GTO, Gerber_drill.GTP]
2020-07-05 Add V1 Board Design.pdf
2020-07-05 Full Report, Presentation, PCB Images
2020-10-05 Started uploading old files
    [Gerber_BoardOutline.GKO, Gerber_BottomLayer.GBL, Gerber_BottomSolderMaskLayer.GBS, Gerber_Drill_PTH.DRL, Gerber_TopLayer.GTL, Gerber_TopPasteMaskLayer.GTP, Gerber_TopSilkLayer.GTO, Gerber_TopSolderMaskLayer.GTS]
2020-10-05 Rest of downloads from EasyEDA
    [ADT75.schdoc, BMP180.schdoc, BOM_D1_2020-10-05_16-57-24.csv, BOM_D2_2020-10-05_16-55-55.csv, BOM_D3_2020-10-05_16-58-42.csv, BOM_D5_2020-10-05_16-57-39.csv, D2 PCB Final_2020-10-05_16-49-59.dxf, D4_2020-10-05_17-05-55.dxf]
